mostlydiyrf/p3st/docs/P3ST_Partslist.xls

Sheet: P3ST_Parts
Mostly DIY RF / P3ST Transceiver Parts List
Ref | Qty | Value | Comment | Each | Ext |  | On Hand | Order
Motherboard
D1, D2, D3, D4, | 4 | 1N4148 DO-35 | DK 1N4148FS-ND | $0.020 | $0.08
J1, J5, | 22 | Female socket header 1x4 | DK S7002-ND | $0.232 | $5.10
K1, K2, K3, | 3 | DPDT | DK TX2-12V | $1.710 | $5.13
K4, | 1 | SPDT Relay | DK J102K1CS312VDC.20 | $0.935 | $0.94
Coax | 6ft | RG174 | Amazon / MOOKEERF | $0.260 | $1.66
Q1 | 1 | IRF9Z24NPBF P-Channel MOSFET | DK IRF9Z24NPBF-ND $0.75 | $0.750 | $0.75
Cable, 3-conductor | 2ft | Red, Green, White, 22AWG | Amazon / AOTOINK | $0.160 | $0.32
LCD Display | 1 | 16x2, 5V, I2C | Amazon / Teyleten | $2.780 | $2.78
Rotary Encoder module | 1 | KY-040 | Amazon / TAISS | $2.000 | $2.00
Potentiometer, 10K | 2 | 10K Audio Taper | Mouser 652-PDB181E420K103A2 | $0.970 | $1.94
PCB | 1 |  |  | $4.250 | $4.25
 |  |  | Module Total |  |  | $24.95
Audio Output Amp
Ref | Qty | Value |  |  |  |  | O.H | Order
C1, | 1 | 100μF electrolytic, radial, pins 0.1” | DK 732-8825-1-ND | $0.110 | $0.11
C2, | 1 | 10μF electrolytic, radial, pins 0.1” | DK 4191-EM1H100MP26307F2P9UCT-ND | $0.190 | $0.19
C3, | 1 | 470μF electrolytic, radial, pins 0.1” | DK 732-8708-1-ND | $0.130 | $0.13
C4, | 1 | 22μF electrolytic, radial, pins 0.1” | DK 732-8767-1-ND | $0.110 | $0.11
C5, C6, | 2 | 220μF electrolytic, radial, pins 0.1” | DK 732-8634-1-ND | $0.150 | $0.15
J1, J2, | 2 | Pin header, 1x4, right-angle | Amazon / Ruiwaer | $0.180 | $0.18
J5 | 1 | Pin Header, 1x3 | Amazon / | $0.050 | $0.05
Q1, | 1 | 2N2222A (TO-18) | EBay / LF Components | $0.800 | $0.80
R1, | 1 | 100K 1/4W carbon film | DK 13-CFR-25JT-52-100KCT-ND | $0.020 | $0.020
R2, | 1 | 47K 1/4W carbon film | DK 13-CFR-25JT-52-47KCT-ND | $0.020 | $0.020
R3, | 1 | 100 1/4W carbon film | DK 13-CFR-25JT-52-100RCT-ND | $0.020 | $0.020
R4, | 1 | 2.2K 1/4W carbon film | DK 13-CFR25SJT-52-2K2CT-ND | $0.020 | $0.020
R5, | 1 | 1K 1/4W carbon film | DK 13-CFR-25JT-52-100RCT-ND | $0.020 | $0.020
R6, | 1 | 2.2 1/4W carbon film | DK 2.2QBK-ND | $0.010 | $0.10
U1, | 1 | LM380N, 14-pin | DK 296-LM380N/NOPB-ND | $1.090 | $1.09
PCB | 1 |  |  | $0.500 | $0.50
 |  |  | Module Total |  |  | $3.01
BFO Mixer
Ref | Qty | Value
U1, | 1 | ADE-1 | DK 3157-ADE-1+CT-ND | $4.930 | $4.93
J1, J2, | 2 | Pin header, 1x4, right-angle |  | $0.090 | $0.18
PCB |  |  | JLC | $0.500 | $0.50
 |  |  | Module Total |  |  | $5.61
VFO Mixer
Ref | Qty | Value
U1, | 1 | ADE-1 | DK 3157-ADE-1+CT-ND | $4.930 | $4.93
J1, J2, | 2 | Pin header, 1x4, right-angle |  | $0.090 | $0.18
PCB |  |  | JLC | $0.500 | $0.50
 |  |  | Module Total |  |  | $5.61
Final Lowpass Filter
Ref | Qty | Value
C1, C4, | 2 | 220pF NP0/C0G ceramic | DK 399-13974-2-ND | $0.140 | $0.28
C2, C3, | 2 | 330pF NP0/C0G ceramic | DK 399-4231-ND | $0.140 | $0.28
C5, | 1 | 47pF NP0/C0G ceramic | DK 399-14095-1-ND | $0.210 | $0.21
L1, L2, L3, | 3 | T50-7 toroid core | Kits&Parts | $0.210 | $0.63
J1, J2, | 2 | Pin header, 1x4, right-angle | Amazon / | $0.090 | $0.18
Magnet Wire, 26AWG | 36” |  | Amazon / |  | $0.10
PCB |  |  | JLC | $0.500 | $0.50
 |  |  | Module Total |  |  | $2.18
Front-End Bandpass
Ref | Qty | Value
C1, C3, | 2 | 14.8pF trim capacitor | DK 2447-GKG30015-ND | $0.690 | $1.38
C2, | 1 | 1.5pF hand-made “gimmick” | Salvage | $0.000 | $0.00
C4, C5, | 2 | 39pF trim capacitor | DK 2447-GKG60015-ND | $0.690 | $1.38
J1, J2, | 2 | Pin header, 1x4, right-angle |  | $0.090 | $0.18
L1, L2, | 2 | T50-7 toroid | Kits&Parts | $0.210 | $0.42
Magnet Wire, 26AWG | 30” |  |  |  | $0.15
PCB |  |  |  | $0.500 | $0.50
 |  |  | Module Total |  |  | $4.01
IF Module
Ref | Qty | Value
C1 – C10 | 10 | 0.1μF ceramic X7R radial 0.10” | DK 399-C320C104K5R5TA7305CT-ND | $0.063 | $0.63
C11, C20 | 1 | 220pF 0.10” | DK 399-C315C221J1G5HA7303CT-ND | $0.160 | $0.32
C13 – C19 | 7 | 47pF NP0/C0G ceramic 0.10” | DK BC1009CT-ND | $0.060 | $0.42
J1 – J3 | 3 | Pin header, 1x4, right-angle | Amazon / | $0.090 | $0.18
L1, L4, | 2 | 22μH molded axial | DK 118-77F220K-TR-RCCT-ND | $0.170 | $0.34
L2, L3, | 2 | T50-7 toroid core | Kits&Parts | $0.210 | $0.42
Q1, Q2, | 2 | 2N2222A (TO-18) | EBay / LF Components | $0.800 | $1.60
R1, | 1 | 100 1/4W carbon film | DK 13-CFR-25JT-52-100RCT-ND | $0.020 | $0.02
R2, R8, | 2 | 680 1/4W carbon film | DK 13-CFR-25JT-52-680RCT-ND | $0.020 | $0.04
R3, R9, | 2 | 3K 1/4W carbon film | Mouser 603-CFR-25JB-52-3K | $0.010 | $0.02
R4, R7, | 2 | 1K 1/4W carbon film | DK 13-CFR-25JT-52-1KCT-ND | $0.020 | $0.04
R5, R11, | 2 | 10 1/4W carbon film | DK 13-CFR-25JR-52-10RCT-ND | $0.010 | $0.02
R12, | 1 | 51 1/4W carbon film | DK 13-CFR-25JR-52-51RCT-ND | $0.020 | $0.02
Y1 – Y10, | 10 | Crystal, HC49u, 4.915MHz | DK X1014-ND | $0.463 | $4.63
Magnet Wire, 26AWG | 36” |  | Amazon / |  | $0.20
PCB | 1 |  | JLC |  | $0.75
 |  |  | Module Total |  |  | $7.34
Microphone Amp
Ref | Qty | Value
C1, | 1 | 100μF electrolytic, radial, pins 0.1” | DK 732-8825-1-ND | $0.110 | $0.11
C2, | 1 | 470μF electrolytic, radial, pins 0.1” | DK 732-8708-1-ND | $0.130 | $0.13
C3, | 1 | 10μF electrolytic, radial, pins 0.1” | DK 4191-EM1H100MP26307F2P9UCT-ND | $0.190 | $0.19
C4, | 1 | 0.22μF, ceramic | DK 445-181223-ND | $0.180 | $0.18
C5, | 1 | 22μF electrolytic, radial, pins 0.1” | DK 732-8767-1-ND | $0.110 | $0.11
J1, J2, | 2 | Pin header, 1x4, right-angle | Amazon / | $0.090 | $0.18
J4 | 2 | Pin header, 1x3 | Amazon / | $0.050 | $0.05
JP | 1 | Jumper block, 2pin, 0.10” | Amazon / | $0.050 | $0.05
Q1, | 1 | 2N2222A (TO-18) | EBay / LF Components | $0.800 | $0.80
R1, | 1 | 47K 1/4W carbon film | DK 13-CFR-25JT-52-47KCT-ND | $0.020 | $0.02
R2, | 1 | 100K 1/4W carbon film | DK 13-CFR-25JT-52-100KCT-ND | $0.020 | $0.02
R3, | 1 | 100 1/4W carbon film | DK 13-CFR-25JT-52-100RCT-ND | $0.020 | $0.02
R4, | 1 | 1K 1/4W carbon film | DK 13-CFR-25JT-52-100RCT-ND | $0.020 | $0.02
R5, | 1 | 2.2K 1/4W carbon film | DK 13-CFR25SJT-52-2K2CT-ND | $0.020 | $0.02
R6, R7, | 2 | 4.7K 1/4W carbon film | DK 13-CFR-25JT-52-4K7CT-ND | $0.020 | $0.04
PCB | 1 |  | JLC | $0.500 | $0.50
 |  |  | Module Total |  |  | $2.44
RF Amp
Ref | Qty | Value
C1, | 1 | 0.01μF, ceramic 0.10” | DK 399-13905-1-ND | $0.140 | $0.14
C2, C4, C5, | 3 | 0.1μF, ceramic 0.10” | DK 399-C320C104K5R5TA7305CT-ND | $0.063 | $0.06
C3, | 1 | 0.047μF, ceramic 0.10” | DK BC1082CT-ND | $0.176 | $0.18
J1, J2, | 2 | Pin header, 1x4, right-angle | Amazon / | $0.090 | $0.18
L1, | 1 | 22μH, molded | DK 118-77F220K-TR-RCCT-ND | $0.170 | $0.17
Q1, | 1 | 2N2222A (TO-18) | EBay / LF Components | $0.800 | $0.80
R1, R3, | 2 | 3K 1/4W carbon film | Mouser 603-CFR-25JB-52-3K | $0.010 | $0.02
R2, | 1 | 680 1/4W carbon film | DK 13-CFR-25JT-52-680RCT-ND | $0.020 | $0.02
R4, | 1 | 10 1/4W carbon film | DK 13-CFR-25JR-52-10RCT-ND | $0.010 | $0.01
R7, | 1 | 330 1/4W carbon film | DK 13-CFR-25JT-52-330RCT-ND | $0.020 | $0.02
PCB | 1 |  | JLC | $0.500 | $0.50
 |  |  | Module Total |  |  | $2.10
Driver & Final Amp
Ref | Qty | Value
C1, | 1 | 0.01μF 0.2” | Mouser 80-C322C103K5R-TR | $0.150 | $0.15
C2, C4, C5, C6, C7, C8, C10, C11, C12, | 9 | 0.1μF 0.2” | Mouser 80-C318C104K5R5TATU | $0.154 | $1.39
C3, | 1 | 0.047μF 0.2” | DK BC1082CT-ND | $0.176 | $0.180
C9, | 1 | 220uF aluminum electrolytic | DK 732-8634-1-ND | $0.150 | $0.15
J1, J2, J3, | 3 | Pin header, 1x4, right-angle | Amazon / | $0.090 | $0.27
J | 2 | Pin header, 1x2, straight | Amazon / | $0.030 | $0.03
L1 | 2 | 22μH, molded, axial | DK 118-77F220K-TR-RCCT-ND | $0.170 | $0.17
L2, | 1 | 22μH, molded, radial | DK 495-6964-1-ND | $0.244 | $0.24
Q1, | 1 | 2N2219A | Jameco 38228 | $1.420 | $1.42
Q2, | 1 | IRF510 MOSFET TO-223 | DK IRF510PBF-ND | $0.780 | $0.78
Heat Sink | 1 | TO-220 Black / Wakefield-Vette | DK 345-1020-ND | $0.440 | $0.44
Heat Sink | 1 | TO-39 Black Crown / Boyd Laconia | DK 325705B00000G-ND | $2.060 | $2.06
R1, R3, | 2 | 2.7K 1/4W carbon film | DK 13-CFR-25JT-52-2K7CT-ND | $0.020 | $0.04
R2, | 1 | 680 1/4W carbon film | DK 13-CFR-25JT-52-680RCT-ND | $0.020 | $0.02
R4, R7, | 2 | 10 1/4W carbon film | DK 13-CFR-25JR-52-10RCT-ND | $0.010 | $0.02
R8, | 1 | 270 1/4W carbon film | DK 13-CFR-25JR-52-270RCT-ND | $0.020 | $0.02
R9, | 1 | 1K 1/4W carbon film | DK 13-CFR-25JT-52-100RCT-ND | $0.020 | $0.02
R10, | 1 | 51 1/4W carbon film | DK 13-CFR-25JR-52-51RCT-ND | $0.020 | $0.02
RV1, | 1 | 10K trim pot | DK 3362P-103LF-ND | $0.910 | $0.91
4-40 Screw/Nut | 1 |  |  | $0.050 | $0.05
T1, | 1 | FT50-43 Toroid Core | Kits&Parts | $0.400 | $0.40
U1, | 1 | LM317L, 3.3V regulator TO-92 | DK LM317LZRAGOSCT-ND | $0.490 | $0.49
Magnet Wire, 27AWG | 1 | Red, Green, twisted 8T/inch | Amazon / | $0.100 | $0.10
PCB | 1 |  | JLC | $0.750 | $0.75
 |  |  | Module Total |  |  | $10.12
Digital VFO/BFO
Ref | Qty | Value
C2, C4, | 2 | 220uF SMD | DK 399-6680-1-ND | $0.530 | $1.06
C11, C12, | 2 | 10μF SMD | DK 478-CM105X5R106K16ATCT-ND | $0.147 | $0.29
D1, | 1 | PMEG2010ER SMD | DK 1727-5192-1-ND | $0.183 | $0.18
J1, J2, | 1 | Pin header, 1x4, right-angle | Amazon / | $0.090 | $0.27
L1, | 1 | 680μH SMD | DK 445-180928-1-ND | $0.198 | $0.20
U1, | 1 | Si5351A, clone, | Amazon / Teyleten | $3.960 | $3.96
U2, | 1 | XIAO 2040 | Seeed (direct) | $3.500 | $3.50
U3, | 1 | TLV1117LV-3.3 Regulator, SMD | DK 296-21112-1-ND | $0.278 | $0.28
PCB | 1 |  | JLC | $0.500 | $0.50
 |  |  | Module Total |  |  | $10.24
 |  |  | Grand Total |  | $80.42

Sheet: Grouped
P3ST Transceiver Kit / Master Parts List 1.17.2025 |  | 1.16.25
Capacitors | Qty | Source & Part Number | Ea | Ext
0.01μF, ceramic, 0.20" LS | 1 | Mouser 80-C322C103K5R-TR | $0.150 | $0.15
0.01μF, ceramic, 0.10" LS | 1 | Digikey 399-13905-1-ND | $0.140 | $0.14
0.047μF, ceramic, 0.2” | 1 | Digikey 1C20X7R473K050B-ND | $0.176 | $0.18
0.047μF, ceramic 0.10" LS | 1 | Digikey BC1082CT-ND | $0.218 | $0.22
0.1μF, ceramic, 0.20" LS | 9 | Mouser 80-C318C104K5R5TATU | $0.154 | $1.39
0.1μF, ceramic 0.10" LS | 13 | Digikey 399-C320C104K5R5TA7305CT-ND | $0.063 | $0.82
0.22μF, ceramic, 0.10” LS | 1 | Digikey 445-181223-ND | $0.180 | $0.18
1.5pF, hand-made “gimmick” | 1 | (salvage 20-24AWG solid wire) | $0.000 | $0.00
100μF, electrolytic, radial, pins 0.1” | 2 | Digikey 732-8825-1-ND | $0.110 | $0.22
10μF, electrolytic, radial, pins 0.1” | 2 | Digikey 4191-EM1H100MP26307F2P9UCT-ND | $0.190 | $0.38
10μF, SMD | 2 | Digikey 478-CM105X5R106K16ATCT-ND | $0.147 | $0.29
14.8pF, trim capacitor | 2 | Digikey 2447-GKG30015-ND | $0.690 | $1.38
220pF, NP0/C0G ceramic 0.20" LS | 2 | Digikey 399-13974-2-ND | $0.140 | $0.28
220pF, NP0/C0G 0.10" LS | 1 | Digikey 399-C315C221J1G5HA7303CT-ND | $0.160 | $0.16
220uF, SMD | 2 | Digikey 399-6680-1-ND | $0.530 | $1.06
220μF, electrolytic, radial, pins 0.1” | 3 | Digikey 732-8634-1-ND | $0.150 | $0.45
22μF, electrolytic, radial, pins 0.1” | 2 | Digikey 732-8767-1-ND | $0.110 | $0.22
330pF, NP0/C0G ceramic 0.20" LS | 2 | Digikey 399-4231-ND | $0.140 | $0.28
39pF, trim capacitor | 2 | Digikey 2447-GKG60015-ND | $0.690 | $1.38
470μF, electrolytic, radial, pins 0.1” | 2 | Digikey 732-8708-1-ND | $0.130 | $0.26
47pF, NP0/C0G ceramic 0.20" LS | 1 | Digikey 399-14095-1-ND | $0.210 | $0.21
47pF, NP0/C0G ceramic 0.10" LS | 7 | Digikey BC1009CT-ND | $0.060 | $0.42
Crystals | Qty | Source & Part Number | Ea | Ext
Crystal, HC49u, 4.915MHz | 10 | Digikey X1014-ND | $0.463 | $4.63
Diodes | Qty | Source & Part Number | Ea | Ext
PMEG2010ER SMD | 1 | Digikey 1727-5192-1-ND | $0.183 | $0.18
1N4148 DO-35 | 4 | Digikey 1N4148FS-ND | $0.020 | $0.08
Hardware | Qty | Source & Part Number | Ea | Ext
Screw/Nut, 4-40 | 1 | Ace Hardware | $0.050 | $0.05
TO-220 Black / Wakefield-Vette | 1 | Digikey 345-1020-ND | $0.440 | $0.44
TO-39 Black Crown / Boyd Laconia | 1 | Digikey 325705B00000G-ND | $2.060 | $2.06
Headers | Qty | Source & Part Number | Ea | Ext
Pin header, 1x2, straight | 2 | Amazon / HiLetgo (from 40-pin, 0.10”) | $0.030 | $0.06
Pin header, 1x3 | 3 | Amazon / HiLetgo (from 40-pin, 0.10”) | $0.050 | $0.15
Pin header, 1x4, right-angle | 22 | Amazon / Ruiwaer (from 40-pin, 0.10”) | $0.090 | $1.98
Female socket header 1x4 | 22 | Digikey S7002-ND | $0.232 | $5.10
Jumper block, 2pin, 0.10" LS | 3 | Amazon / California JOS | $0.050 | $0.15
Inductors | Qty | Source & Part Number | Ea | Ext
22μH, molded, axial | 5 | Digikey 118-77F220K-TR-RCCT-ND | $0.170 | $0.85
22μH, molded, radial | 1 | Digikey 495-6964-1-ND | $0.244 | $0.24
680μH SMD | 1 | Digikey 445-180928-1-ND | $0.198 | $0.20
Integrated | Qty | Source & Part Number | Ea | Ext
LM380N, 14-pin | 1 | Digikey 296-LM380N/NOPB-ND | $1.090 | $1.09
ADE-1 | 2 | Digikey 3157-ADE-1+CT-ND | $4.930 | $9.86
LM317L, 3.3V regulator TO-92 | 1 | Digikey LM317LZRAGOSCT-ND | $0.490 | $0.49
TLV1117LV-3.3 Regulator, SMD | 1 | Digikey 296-21112-1-ND | $0.278 | $0.28
Modules | Qty | Source & Part Number | Ea | Ext
LCD Display, 16x2, 5V, I2C | 1 | Amazon / Teyleten | $2.780 | $2.78
Rotary Encoder Module, KY-040 | 1 | Amazon / TAISS | $2.000 | $2.00
XIAO 2040 | 1 | Seeed Studios (direct) | $3.500 | $3.50
Si5351A, clone, | 1 | Amazon / Teyleten | $3.960 | $3.96
Potentiometers | Qty | Source & Part Number | Ea | Ext
10K trim pot | 1 | Digikey 3362P-103LF-ND | $0.910 | $0.91
10K Audio Taper | 2 | Mouser 652-PDB181E420K103A2 | $0.970 | $1.94
Relays | Qty | Source & Part Number | Ea | Ext
DPDT, 12V | 3 | Digikey TX2-12V | $1.710 | $5.13
SPDT, 12V | 1 | Digikey J102K1CS312VDC.20 | $0.935 | $0.94
Resistors | Qty | Source & Part Number | Ea | Ext
10 1/4W carbon film | 5 | Digikey 13-CFR-25JR-52-10RCT-ND | $0.010 | $0.05
100 1/4W carbon film | 3 | Digikey 13-CFR-25JT-52-100RCT-ND | $0.020 | $0.06
100K 1/4W carbon film | 2 | Digikey 13-CFR-25JT-52-100KCT-ND | $0.020 | $0.04
1K 1/4W carbon film | 5 | Digikey 13-CFR-25JT-52-100RCT-ND | $0.020 | $0.10
2.2 1/4W carbon film | 1 | Digikey 2.2QBK-ND | $0.010 | $0.01
2.2K 1/4W carbon film | 2 | Digikey 13-CFR25SJT-52-2K2CT-ND | $0.020 | $0.04
2.7K 1/4W carbon film | 2 | Digikey 13-CFR-25JT-52-2K7CT-ND | $0.020 | $0.04
270 1/4W carbon film | 1 | Digikey 13-CFR-25JR-52-270RCT-ND | $0.020 | $0.02
330 1/4W carbon film | 1 | Digikey 13-CFR-25JT-52-330RCT-ND | $0.020 | $0.02
3K 1/4W carbon film | 4 | Mouser 603-CFR-25JB-52-3K | $0.010 | $0.04
4.7K 1/4W carbon film | 2 | Digikey 13-CFR-25JT-52-4K7CT-ND | $0.020 | $0.04
47K 1/4W carbon film | 2 | Digikey 13-CFR-25JT-52-47KCT-ND | $0.020 | $0.04
51 1/4W carbon film | 2 | Digikey 13-CFR-25JR-52-51RCT-ND | $0.020 | $0.04
680 1/4W carbon film | 4 | Digikey 13-CFR-25JT-52-680RCT-ND | $0.020 | $0.08
Toroids | Qty | Source & Part Number | Ea | Ext
T50-7 toroid core | 7 | kitsandparts.com | $0.210 | $1.47
FT50-43 Toroid Core | 1 | kitsandparts.com | $0.400 | $0.40
Transistors | Qty | Source & Part Number | Ea | Ext
2N2222A (TO-18) | 5 | EBay / LF Components | $0.800 | $4.00
2N2219A (TO-39/TO-5) | 1 | Jameco 38228 | $1.420 | $1.42
IRF510 MOSFET TO-223 | 1 | Digikey IRF510PBF-ND | $0.780 | $0.78
IRF9Z24NPBF P-Channel MOSFET | 1 | Digikey IRF9Z24NPBF-ND $0.75 | $0.750 | $0.75
Wire & Cable | Qty | Source & Part Number | Ea | Ext
3-Conductor Cable, R-G-W, 22AWG | 2ft | Amazon / AOTOINK | $0.160 | $0.32
Coax, RG174 | 6ft | Amazon / MOOKEERF | $0.260 | $1.66
Magnet Wire, 26AWG | 102” | Amazon / BINNEKER |  | $0.10
Magnet Wire, 27AWG, Red, Green | 1 | Amazon / | $0.100 | $0.10

Sheet: Counts
P3ST Master Parts List |  | 1.16.25
Capacitors |  |  | Each | Ext | On Hand
0.01μF, ceramic, 0.20" LS | 1 | Mouser 80-C322C103K5R-TR | $0.150 | $0.15
0.01μF, ceramic, 0.10" LS | 1 | DK 399-13905-1-ND | $0.140 | $0.14
0.047μF, ceramic, 0.2” | 1 | DK BC1082CT-ND | $0.176 | $0.180
0.047μF, ceramic 0.10" LS | 1 | DK BC1082CT-ND | $0.176 | $0.18
0.1μF, ceramic, 0.20" LS | 9 | Mouser 80-C318C104K5R5TATU | $0.154 | $1.39
0.1μF, ceramic 0.10" LS | 13 | DK 399-C320C104K5R5TA7305CT-ND | $0.063 | $0.06
0.22μF, ceramic | 1 | DK 445-181223-ND | $0.180 | $0.18
1.5pF, hand-made “gimmick” | 1 | Salvage (20-24AWG solid wire) | $0.000 | $0.00
100μF, electrolytic, radial, pins 0.1” | 2 | DK 732-8825-1-ND | $0.110 | $0.11
10μF, electrolytic, radial, pins 0.1” | 2 | DK 4191-EM1H100MP26307F2P9UCT-ND | $0.190 | $0.19
10μF, SMD | 2 | DK 478-CM105X5R106K16ATCT-ND | $0.147 | $0.29
14.8pF, trim capacitor | 2 | DK 2447-GKG30015-ND | $0.690 | $1.38
220pF, NP0/C0G ceramic 0.20" LS | 2 | DK 399-13974-2-ND | $0.140 | $0.28
220pF, NP0/C0G 0.10" LS | 1 | DK 399-C315C221J1G5HA7303CT-ND | $0.160 | $0.32
220uF, SMD | 2 | DK 399-6680-1-ND | $0.530 | $1.06
220μF, electrolytic, radial, pins 0.1” | 3 | DK 732-8634-1-ND | $0.150 | $0.15
22μF, electrolytic, radial, pins 0.1” | 2 | DK 732-8767-1-ND | $0.110 | $0.11
330pF, NP0/C0G ceramic 0.20" LS | 2 | DK 399-4231-ND | $0.140 | $0.28
39pF, trim capacitor | 2 | DK 2447-GKG60015-ND | $0.690 | $1.38
470μF, electrolytic, radial, pins 0.1” | 2 | DK 732-8708-1-ND | $0.130 | $0.13
47pF, NP0/C0G ceramic 0.20" LS | 1 | DK 399-14095-1-ND | $0.210 | $0.21
47pF, NP0/C0G ceramic 0.10" LS | 7 | DK BC1009CT-ND | $0.060 | $0.42
Crystals |  |  | Each | Ext | On Hand
Crystal, HC49u, 4.915MHz | 10 | DK X1014-ND | $0.463 | $4.63
Diodes |  |  | Each | Ext | On Hand
PMEG2010ER SMD | 1 | DK 1727-5192-1-ND | $0.183 | $0.18
1N4148 DO-35 | 4 | DK 1N4148FS-ND | $0.020 | $0.08
Hardware |  |  | Each | Ext | On Hand
Screw/Nut, 4-40 | 1 | Ace Hardware | $0.050 | $0.05
TO-220 Black / Wakefield-Vette | 1 | DK 345-1020-ND | $0.440 | $0.44
TO-39 Black Crown / Boyd Laconia | 1 | DK 325705B00000G-ND | $2.060 | $2.06
Headers |  |  | Each | Ext | On Hand
Pin header, 1x2, straight | 2 | Amazon / HiLetgo (from 40-pin, 0.10”) | $0.030 | $0.03
Pin header, 1x3 | 3 | Amazon / HiLetgo (from 40-pin, 0.10”) | $0.050 | $0.05
Pin header, 1x4, right-angle | 22 | Amazon / Ruiwaer (from 40-pin, 0.10”) | $0.090 | $0.18
Female socket header 1x4 | 22 | DK S7002-ND | $0.232 | $5.10
Jumper block, 2pin, 0.10" LS | 3 | Amazon / California JOS | $0.050 | $0.05
Inductors |  |  | Each | Ext | On Hand
22μH, molded, axial | 5 | DK 118-77F220K-TR-RCCT-ND | $0.170 | $0.17
22μH, molded, radial | 1 | DK 495-6964-1-ND | $0.244 | $0.24
680μH SMD | 1 | DK 445-180928-1-ND | $0.198 | $0.20
Integrated |  |  | Each | Ext | On Hand
LM380N, 14-pin | 1 | DK 296-LM380N/NOPB-ND | $1.090 | $1.09
ADE-1 | 2 | DK 3157-ADE-1+CT-ND | $4.930 | $4.93
LM317L, 3.3V regulator TO-92 | 1 | DK LM317LZRAGOSCT-ND | $0.490 | $0.49
TLV1117LV-3.3 Regulator, SMD | 1 | DK 296-21112-1-ND | $0.278 | $0.28
Modules |  |  | Each | Ext | On Hand
LCD Display, 16x2, 5V, I2C | 1 | Amazon / Teyleten | $2.780 | $2.78
Rotary Encoder Module, KY-040 | 1 | Amazon / TAISS | $2.000 | $2.00
XIAO 2040 | 1 | Seeed Studios (direct) | $3.500 | $3.50
Si5351A, clone, | 1 | Amazon / Teyleten | $3.960 | $3.96
Potentiometers |  |  | Each | Ext | On Hand
10K trim pot | 1 | DK 3362P-103LF-ND | $0.910 | $0.91
10K Audio Taper | 2 | Mouser 652-PDB181E420K103A2 | $0.970 | $1.94
Relays |  |  | Each | Ext | On Hand
DPDT, 12V | 3 | DK TX2-12V | $1.710 | $5.13
SPDT, 12V | 1 | DK J102K1CS312VDC.20 | $0.935 | $0.94
Resistors |  |  | Each | Ext | On Hand
100K 1/4W carbon film | 1 | DK 13-CFR-25JT-52-100KCT-ND | $0.020 | $0.020
100 1/4W carbon film | 1 | DK 13-CFR-25JT-52-100RCT-ND | $0.020 | $0.02
47K 1/4W carbon film | 1 | DK 13-CFR-25JT-52-47KCT-ND | $0.020 | $0.02
3K 1/4W carbon film | 2 | Mouser 603-CFR-25JB-52-3K | $0.010 | $0.02
2.7K 1/4W carbon film | 2 | DK 13-CFR-25JT-52-2K7CT-ND | $0.020 | $0.04
51 1/4W carbon film | 1 | DK 13-CFR-25JR-52-51RCT-ND | $0.020 | $0.02
51 1/4W carbon film | 1 | DK 13-CFR-25JR-52-51RCT-ND | $0.020 | $0.02
47K 1/4W carbon film | 1 | DK 13-CFR-25JT-52-47KCT-ND | $0.020 | $0.020
100K 1/4W carbon film | 1 | DK 13-CFR-25JT-52-100KCT-ND | $0.020 | $0.02
680 1/4W carbon film | 1 | DK 13-CFR-25JT-52-680RCT-ND | $0.020 | $0.02
680 1/4W carbon film | 1 | DK 13-CFR-25JT-52-680RCT-ND | $0.020 | $0.02
680 1/4W carbon film | 2 | DK 13-CFR-25JT-52-680RCT-ND | $0.020 | $0.04
100 1/4W carbon film | 1 | DK 13-CFR-25JT-52-100RCT-ND | $0.020 | $0.020
100 1/4W carbon film | 1 | DK 13-CFR-25JT-52-100RCT-ND | $0.020 | $0.02
3K 1/4W carbon film | 2 | Mouser 603-CFR-25JB-52-3K | $0.010 | $0.02
2.2K 1/4W carbon film | 1 | DK 13-CFR25SJT-52-2K2CT-ND | $0.020 | $0.020
1K 1/4W carbon film | 1 | DK 13-CFR-25JT-52-100RCT-ND | $0.020 | $0.02
10 1/4W carbon film | 1 | DK 13-CFR-25JR-52-10RCT-ND | $0.010 | $0.01
1K 1/4W carbon film | 2 | DK 13-CFR-25JT-52-1KCT-ND | $0.020 | $0.04
10 1/4W carbon film | 2 | DK 13-CFR-25JR-52-10RCT-ND | $0.010 | $0.02
1K 1/4W carbon film | 1 | DK 13-CFR-25JT-52-100RCT-ND | $0.020 | $0.020
2.2K 1/4W carbon film | 1 | DK 13-CFR25SJT-52-2K2CT-ND | $0.020 | $0.02
10 1/4W carbon film | 2 | DK 13-CFR-25JR-52-10RCT-ND | $0.010 | $0.02
2.2 1/4W carbon film | 1 | DK 2.2QBK-ND | $0.010 | $0.10
4.7K 1/4W carbon film | 2 | DK 13-CFR-25JT-52-4K7CT-ND | $0.020 | $0.04
330 1/4W carbon film | 1 | DK 13-CFR-25JT-52-330RCT-ND | $0.020 | $0.02
270 1/4W carbon film | 1 | DK 13-CFR-25JR-52-270RCT-ND | $0.020 | $0.02
1K 1/4W carbon film | 1 | DK 13-CFR-25JT-52-100RCT-ND | $0.020 | $0.02
Toroids |  |  | Each | Ext | On Hand
T50-7 toroid core | 7 | Kits&Parts | $0.210 | $0.42
FT50-43 Toroid Core | 1 | Kits&Parts | $0.400 | $0.40
Transistors |  |  | Each | Ext | On Hand
2N2222A (TO-18) | 5 | EBay / LF Components | $0.800 | $0.80
2N2219A (TO-39/TO-5) | 1 | Jameco 38228 | $1.420 | $1.42
IRF510 MOSFET TO-223 | 1 | DK IRF510PBF-ND | $0.780 | $0.78
IRF9Z24NPBF P-Channel MOSFET | 1 | DK IRF9Z24NPBF-ND $0.75 | $0.750 | $0.75
Wire & Cable |  |  | Each | Ext | On Hand
3-Conductor Cable, R-G-W, 22AWG | 2ft | Amazon / AOTOINK | $0.160 | $0.32
Coax, RG174 | 6ft | Amazon / MOOKEERF | $0.260 | $1.66
Magnet Wire, 26AWG | 102” | Amazon / BINNEKER |  | $0.10
Magnet Wire, 27AWG, Red, Green, twisted 8T/inch | 1 | Amazon / | $0.100 | $0.10
