mostlydiyrf/p3st/docs/P3ST_bfo_mixer_Assembly_and_Test.pdf

## Mostly DIY RF / P3ST Transceiver Kit

# BFO Mixer Module

## Assembly and Test Instructions

In keeping with the minimal design philosophy employed in the P3ST, the BFO mixer is an ADE-1+, a commercially-available unit from Mini Circuits. It is a double-balanced diode-ring design requiring an LO drive level of +7dBm. Though it is technically a surface-mount part, it is large enough to handle and solder with no difficulty. Here's its internal circuit:

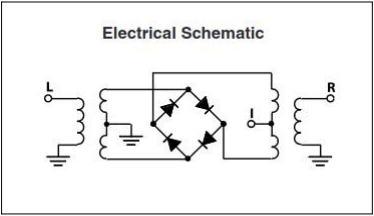
[picture p41: figure]

See attached datasheet for more information.

## Assembly

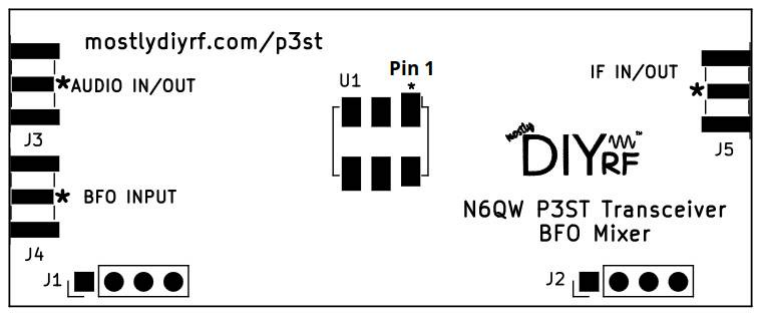
[picture p42: figure]

Assembly could hardly be easier. There are only three components to solder to the module board: two right-angle 4-pin headers and the single ADE-1+. Observe Pin 1 orientation as shown above. Though it's a surface-mount part, it is large enough to handle and solder easily. See the video at https://bit.ly/surface-mount-tips on SMD soldering. The large "D-PAK" component shown is most similar to the ADE-1+ in size. Easy-peasy.

As with the 4-pin headers on all the modules, install them with the right-angle pins extending out the back side of the PCB. Also as with all the modules, the input and output pads may be used either to attach board-edge-style SMA connectors or, with the help of the thru-holes in the middle of the pads, directly-soldered connections may be made.

Mostly DIY RF / P3ST Transceiver Kit / BFO Mixer Module / 2

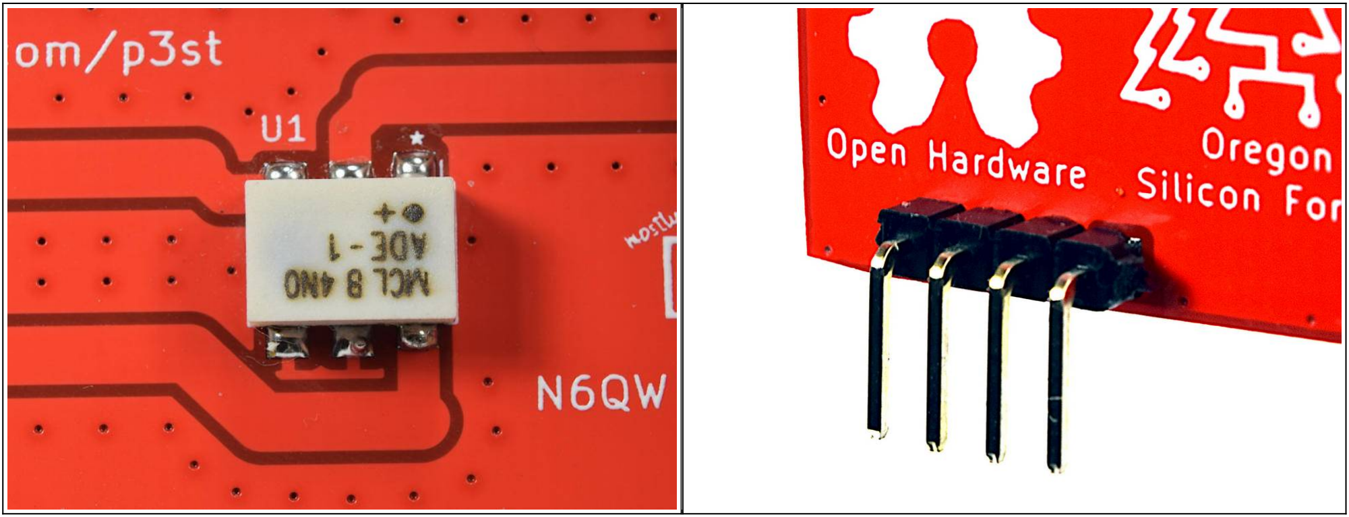
[picture p43: figure]

ADE-1+ orientation. Yes, it mounts upside-down. | Four-pin right-angle head orientation

## Test Procedure

1. Using magnification, visually inspect both sides of the PCB to look for solder bridging or other conductive debris. It's usually best to clean off flux residue first.
2. If you have them, you can test the full operation of the ADE-1+ mixer with a signal generator and spectrum analyzer. For more on doing so, see the video at https://bit.ly/diode-ringmixer and https://bit.ly/testing_dbms. In the alternative (or in addition), you can test for "static" (DC) characteristics by ensuring that:
a) there is continuity (a small resistance of approximately 100mΩ) between Audio IN/OUT

and GND, and between BFO INPUT and GND.

b) there is an apparent resistance (the result of two diode voltage drops) of approximately 8.9KΩ between the IF IN/OUT and GND.
c) there is full continuity between J1 Pin 4 and GND, and between J2 Pins 3 & 4 and

GND.

d) there is no continuity between J1 Pins 1, 2, & 3 and GND, or between J2 Pins 1 & 2

and GND. The ADE-1+ does not need power from the motherboard.


## General Tips and Tricks

■ Save yourself some troubleshooting grief later on: test every part before you install it. Though MDRF uses components only from reputable sources, even those have finite failure rates. Testing is easier than it sounds, and it's quick since you only need to test for part failure.

■ Test resistors for continuity and approximate value (±5%)
■ Test capacitors for no continuity. DC resistance should be infinite or ultra high

after they charge up during testing. Note: this may take several seconds since the current an ohmmeter injects is very low.
■ Test diodes to ensure no reverse continuity and a forward voltage drop of approximately 0.65V.
■ Test transistors for high or infinite collector/drain and emitter/source DC resistance. Use diode test function to test base-emitter junction (base as anode). If you have a dedicated transistor testor, use that.

■ Double-check component markings and color codes. Pin up a reminder chart nearby. Whether you need it or not, look it over before an assembly session.

■ It's usually easiest to begin stuffing parts in the center of a PCB and work your way out.

■ Insert component leads and bend them about 45 degrees to keep the parts from falling out when you flip the board over to solder on the backside.

■ The PCB holes are "through-plated" (copper plated and solder coated on the insides of the holes) for maximum connectivity and mechanical strength, but this makes rework (removing a part and installing a new one) a little more difficult than with other circuit-board methods. So before soldering, double check the component value and orientation.

■ A good habit is to install components such that they are "right-reading" relative to circuit-board nomenclature. For a resistor, this would mean the color code would read from left to right when the silk-screened legend does. For parts oriented vertically, they should read from top to bottom. For other non-polarized parts (such as ceramic capacitors) it's useful to install so their values can be read at a later time (and not, for instance, obscured by another part).

■ Because the power, input, and output pins are closely-spaced, do not use alligator (a.k.a. crocodile) clips for temporary connections. Dupont-style male jumper leads, however, are very convenient for this purpose.

■ Using magnification, visually inspect both sides of the PCB to look for solder bridging or other conductive debris. It's usually best to clean off flux residue first. Isopropyl alcohol (>90%) is excellent for this purpose as it's cheap and dries quickly.
