mostlydiyrf/p3st/errata/M3FOR_cabling_corrections.pdf

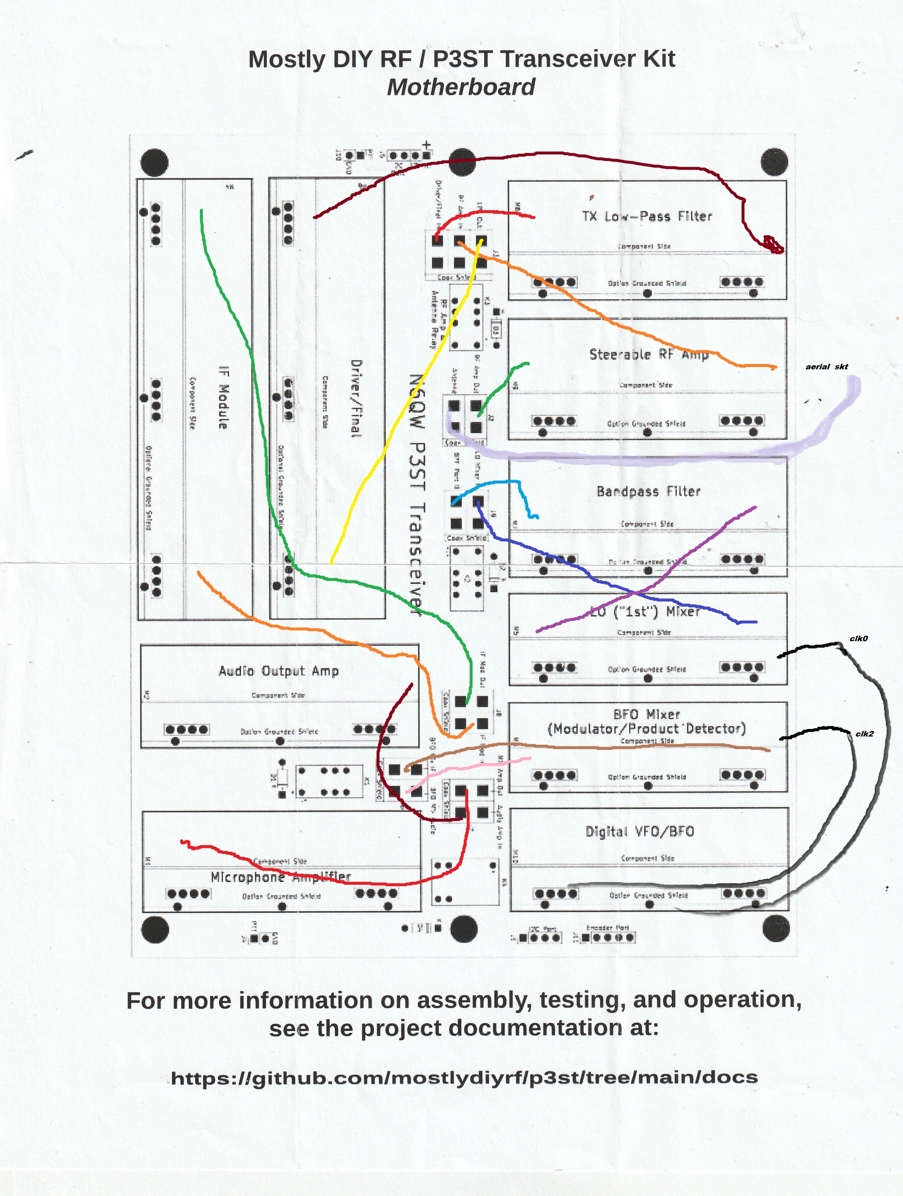
[picture p44: page 1]
