mostlydiyrf/p3st/docs/P3ST_Schematics.pdf

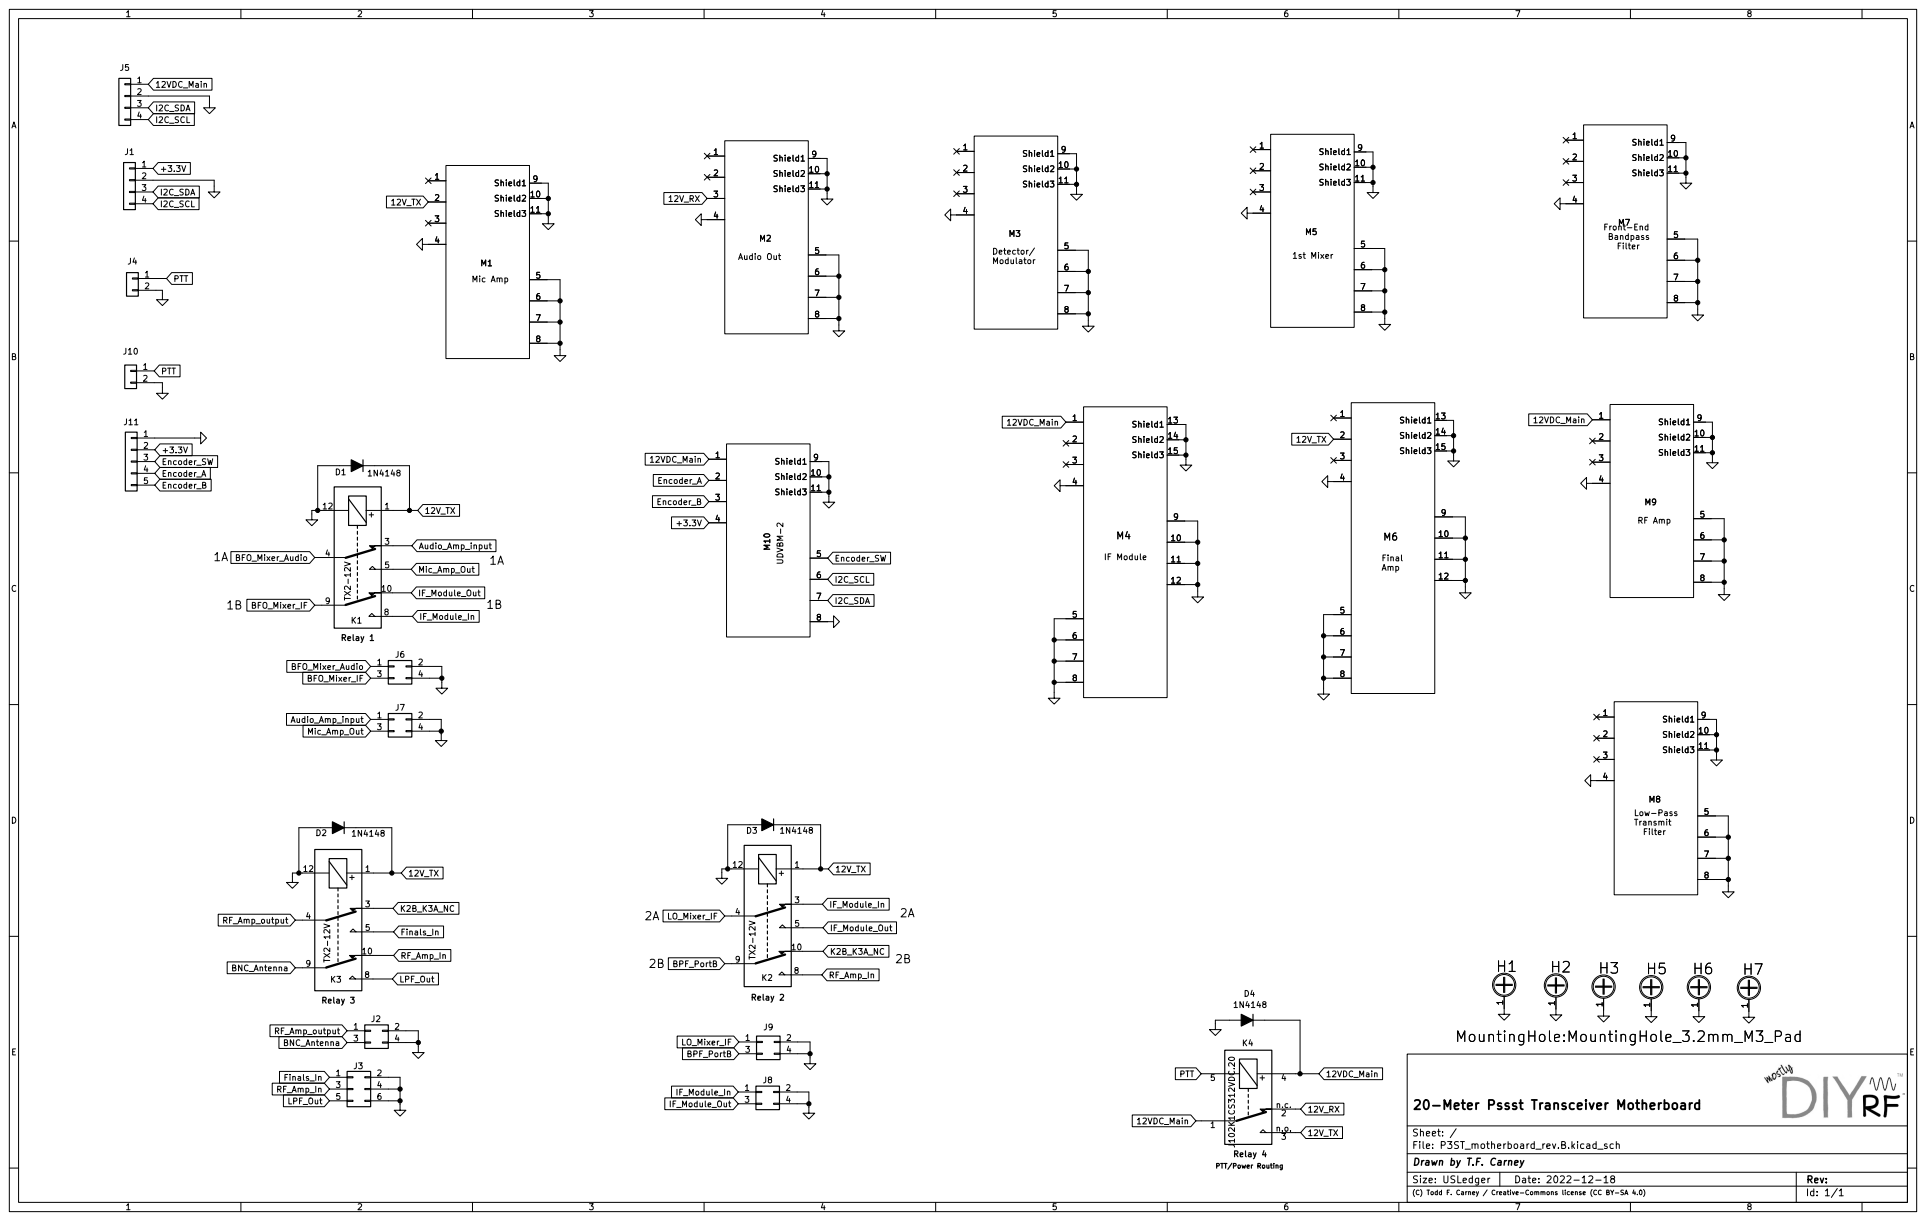
[picture p45: page 1]

Low-Pass Transmit Filter 1A
BFO_Mixer_Audio BFO_Mixer_IF BFO_Mixer_IF BFO_Mixer_Audio Mic_Amp_Out

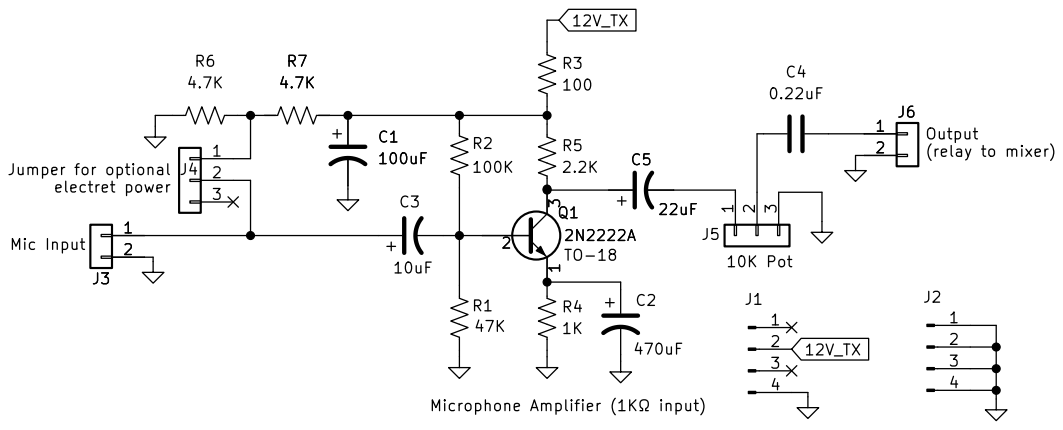
[picture p46: page 2]

Id: 1/1 Drawn by T.F. Carney File: Pssst_microphone_amp.kicad_sch Sheet: / Pssst Microphone Amplifier

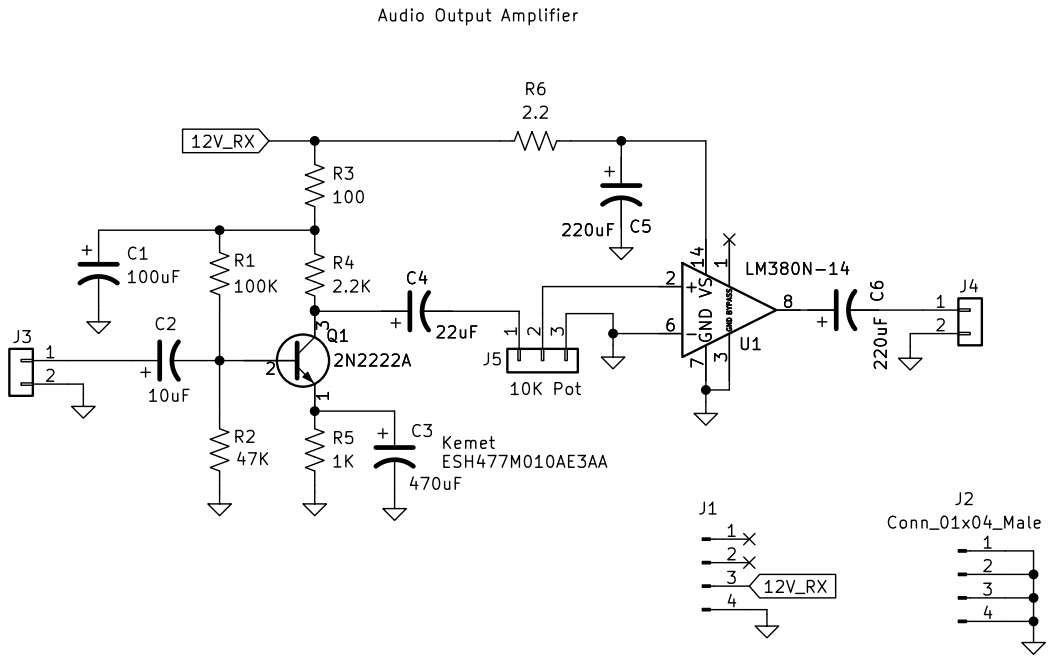
[picture p47: page 3]

Id: 1/1 Drawn by T.F. Carney File: Pssst_audio_out.kicad_sch Sheet: / Pssst Audio Output Amplifier

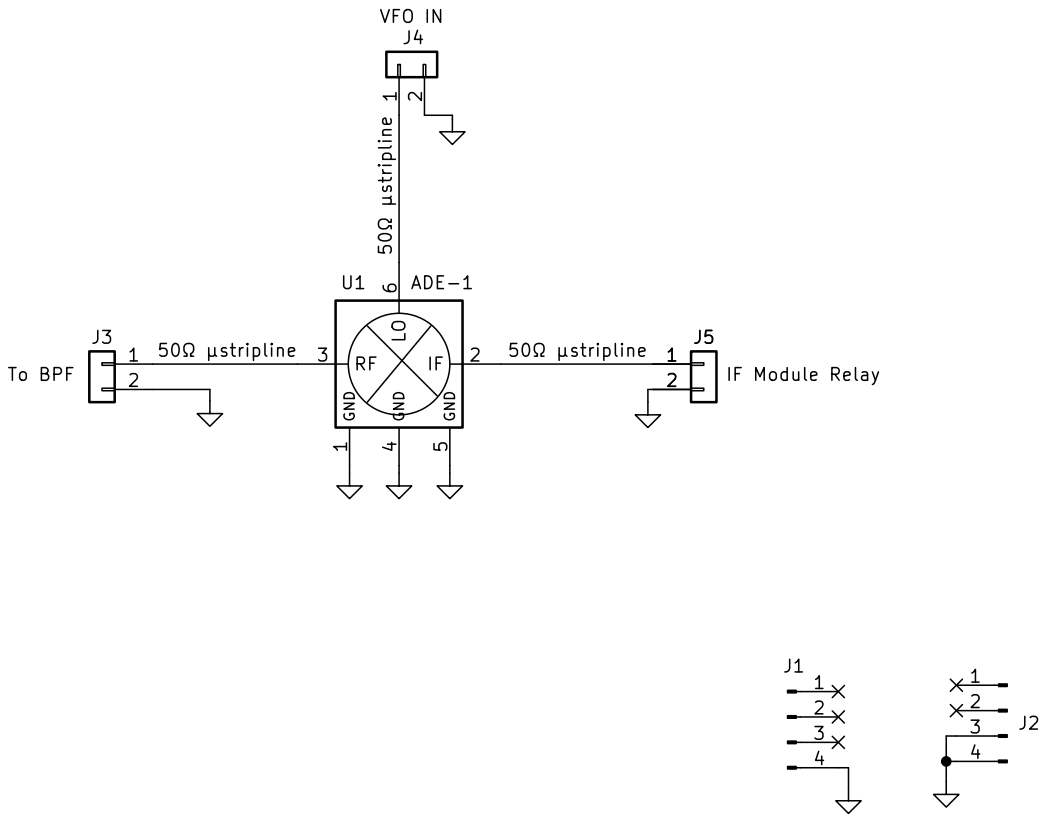
[picture p48: page 4]

Id: 1/1 Drawn by T.F. Carney File: Pssst_VFO_Mixer.kicad_sch Sheet: / Pssst VFO Mixer

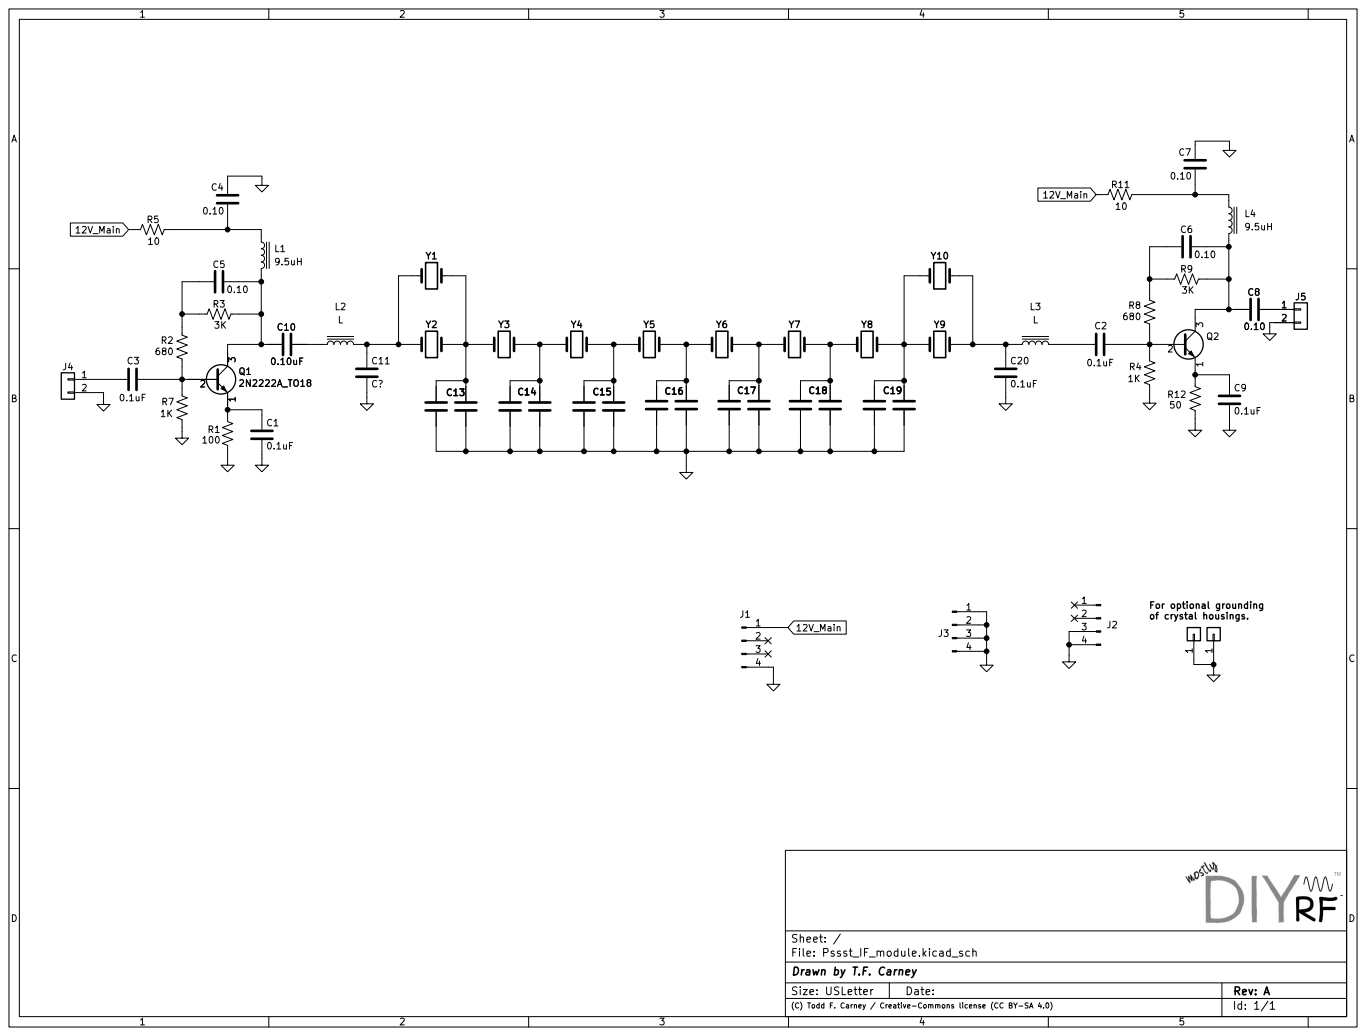
[picture p49: page 5]

Id: 1/1 Drawn by T.F. Carney File: Pssst_IF_module.kicad_sch Sheet: /

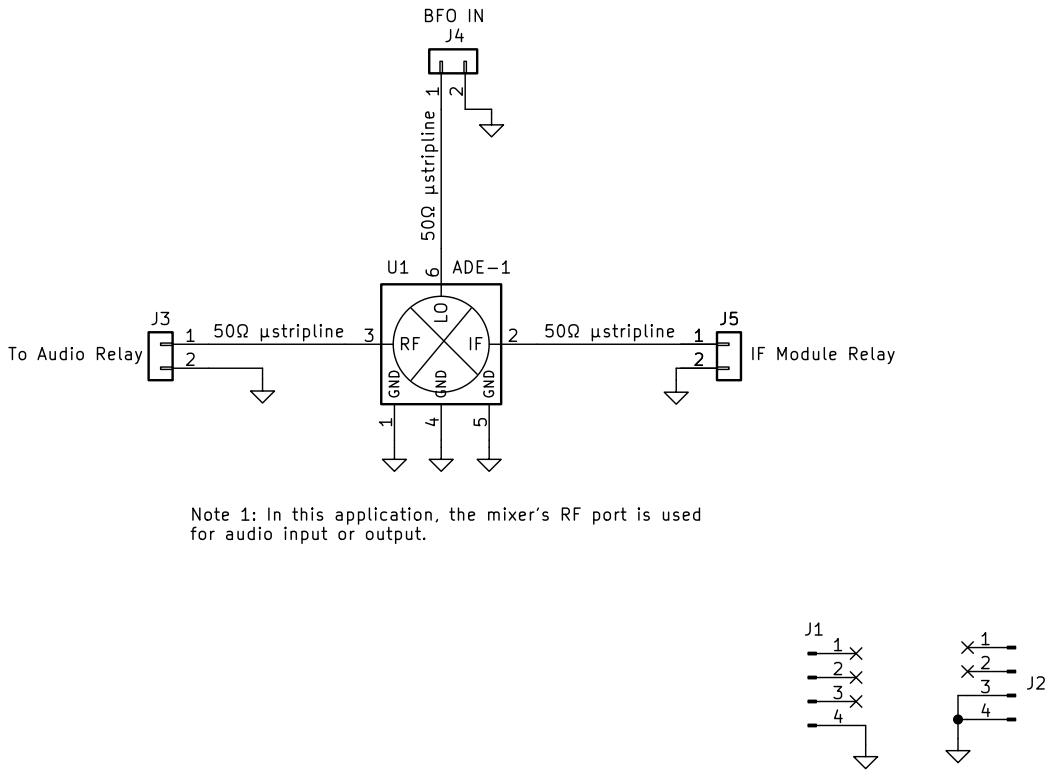
[picture p50: page 6]

Id: 1/1 Drawn by T.F. Carney File: Pssst_BFO_mixer.kicad_sch Sheet: / Pssst BFO Mixer GND

for audio input or output.

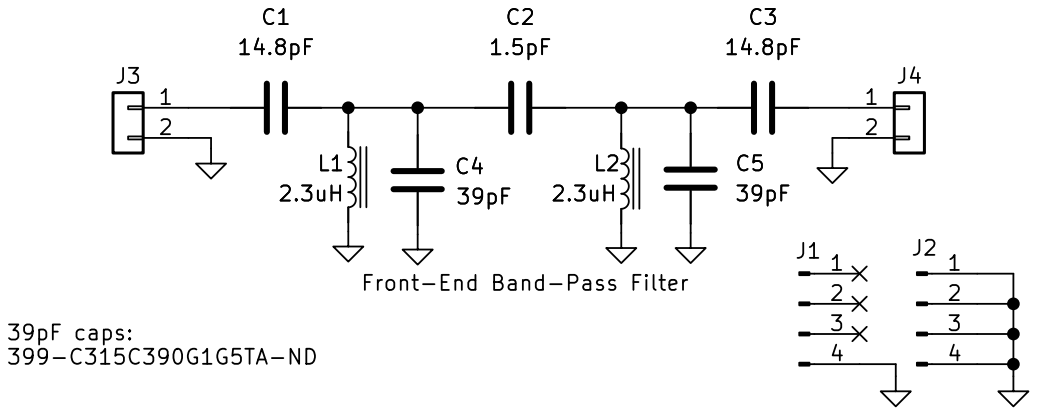
[picture p51: page 7]

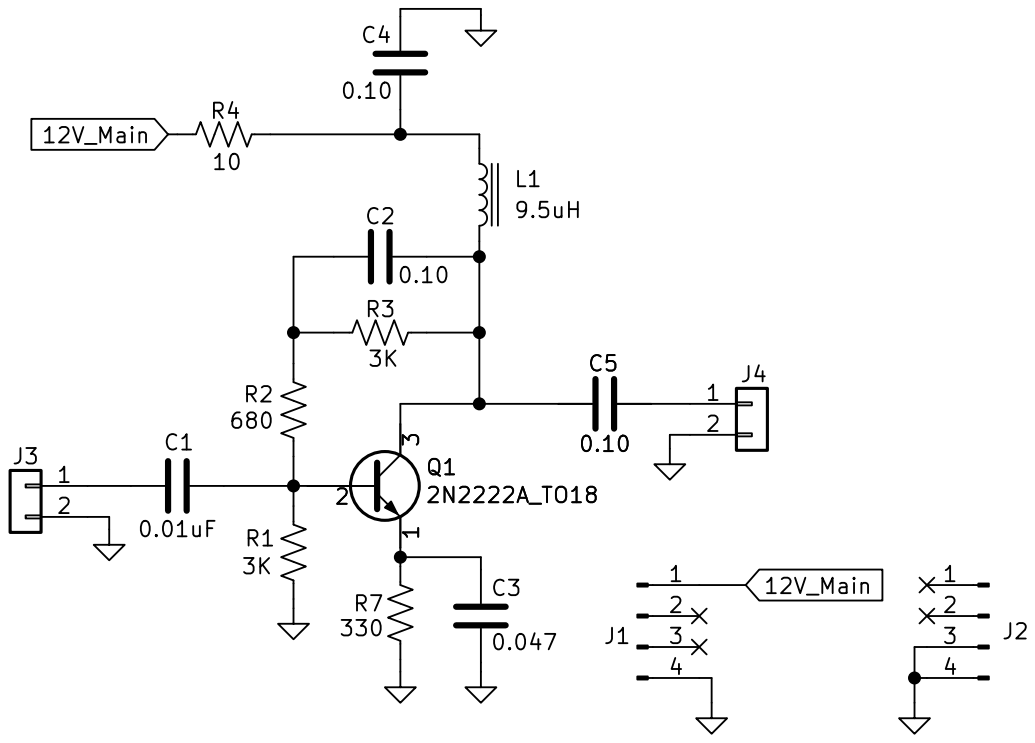
[picture p52: page 8]

Id: 1/1 Drawn by T.F. Carney File: Pssst_RF_amp.kicad_sch Sheet: /

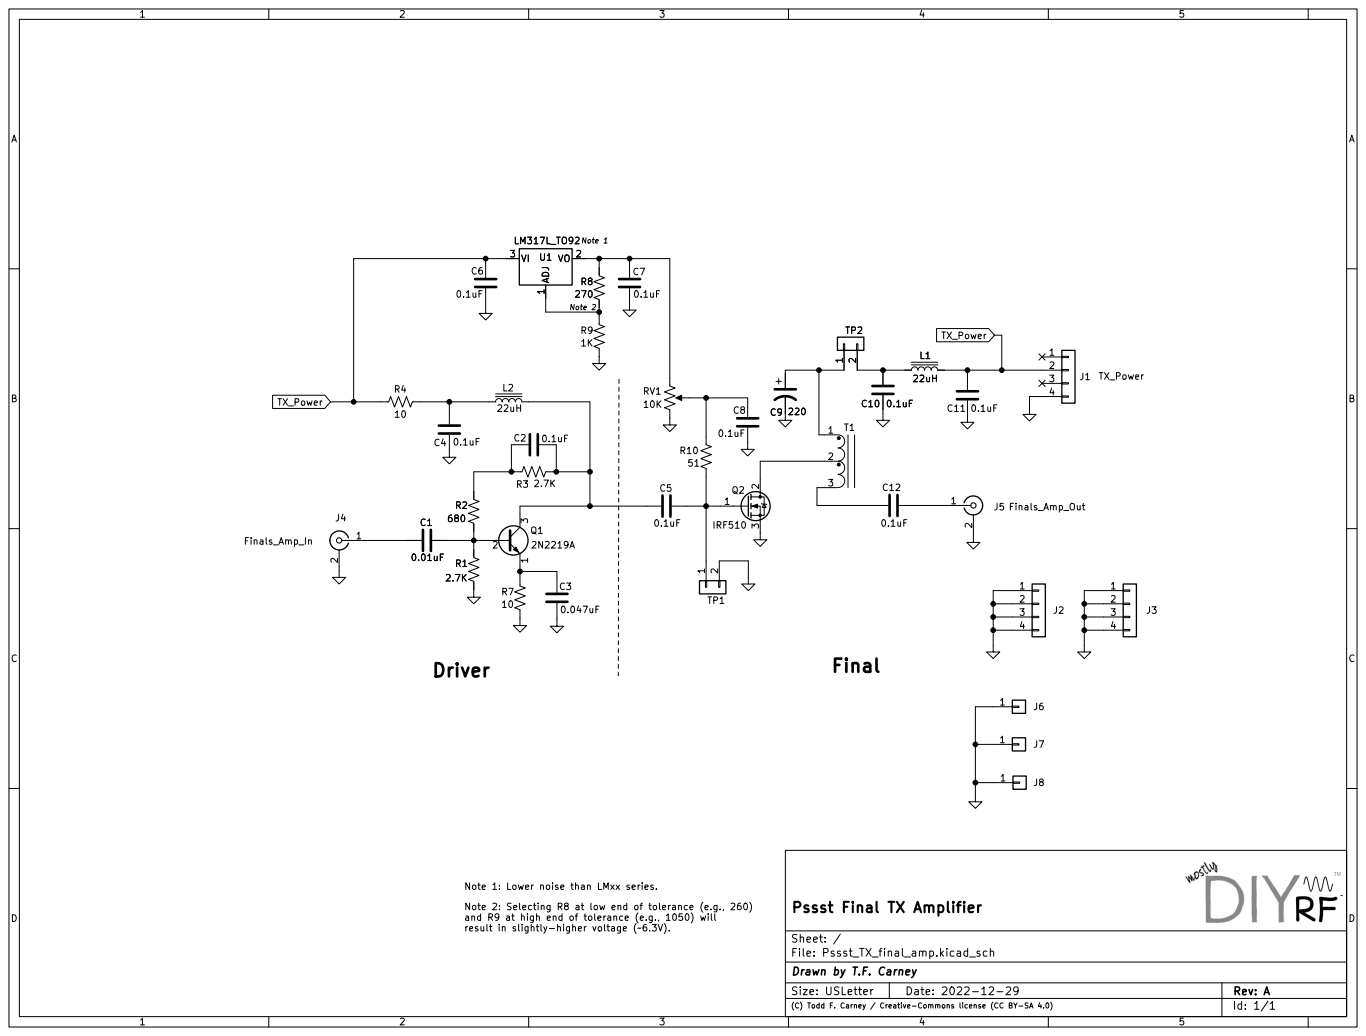
[picture p53: page 9]

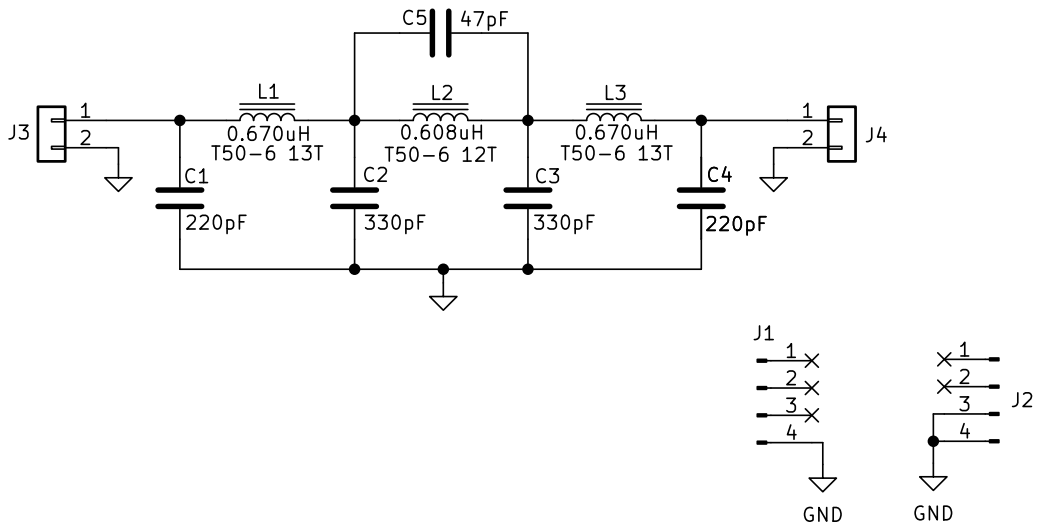
[picture p54: page 10]

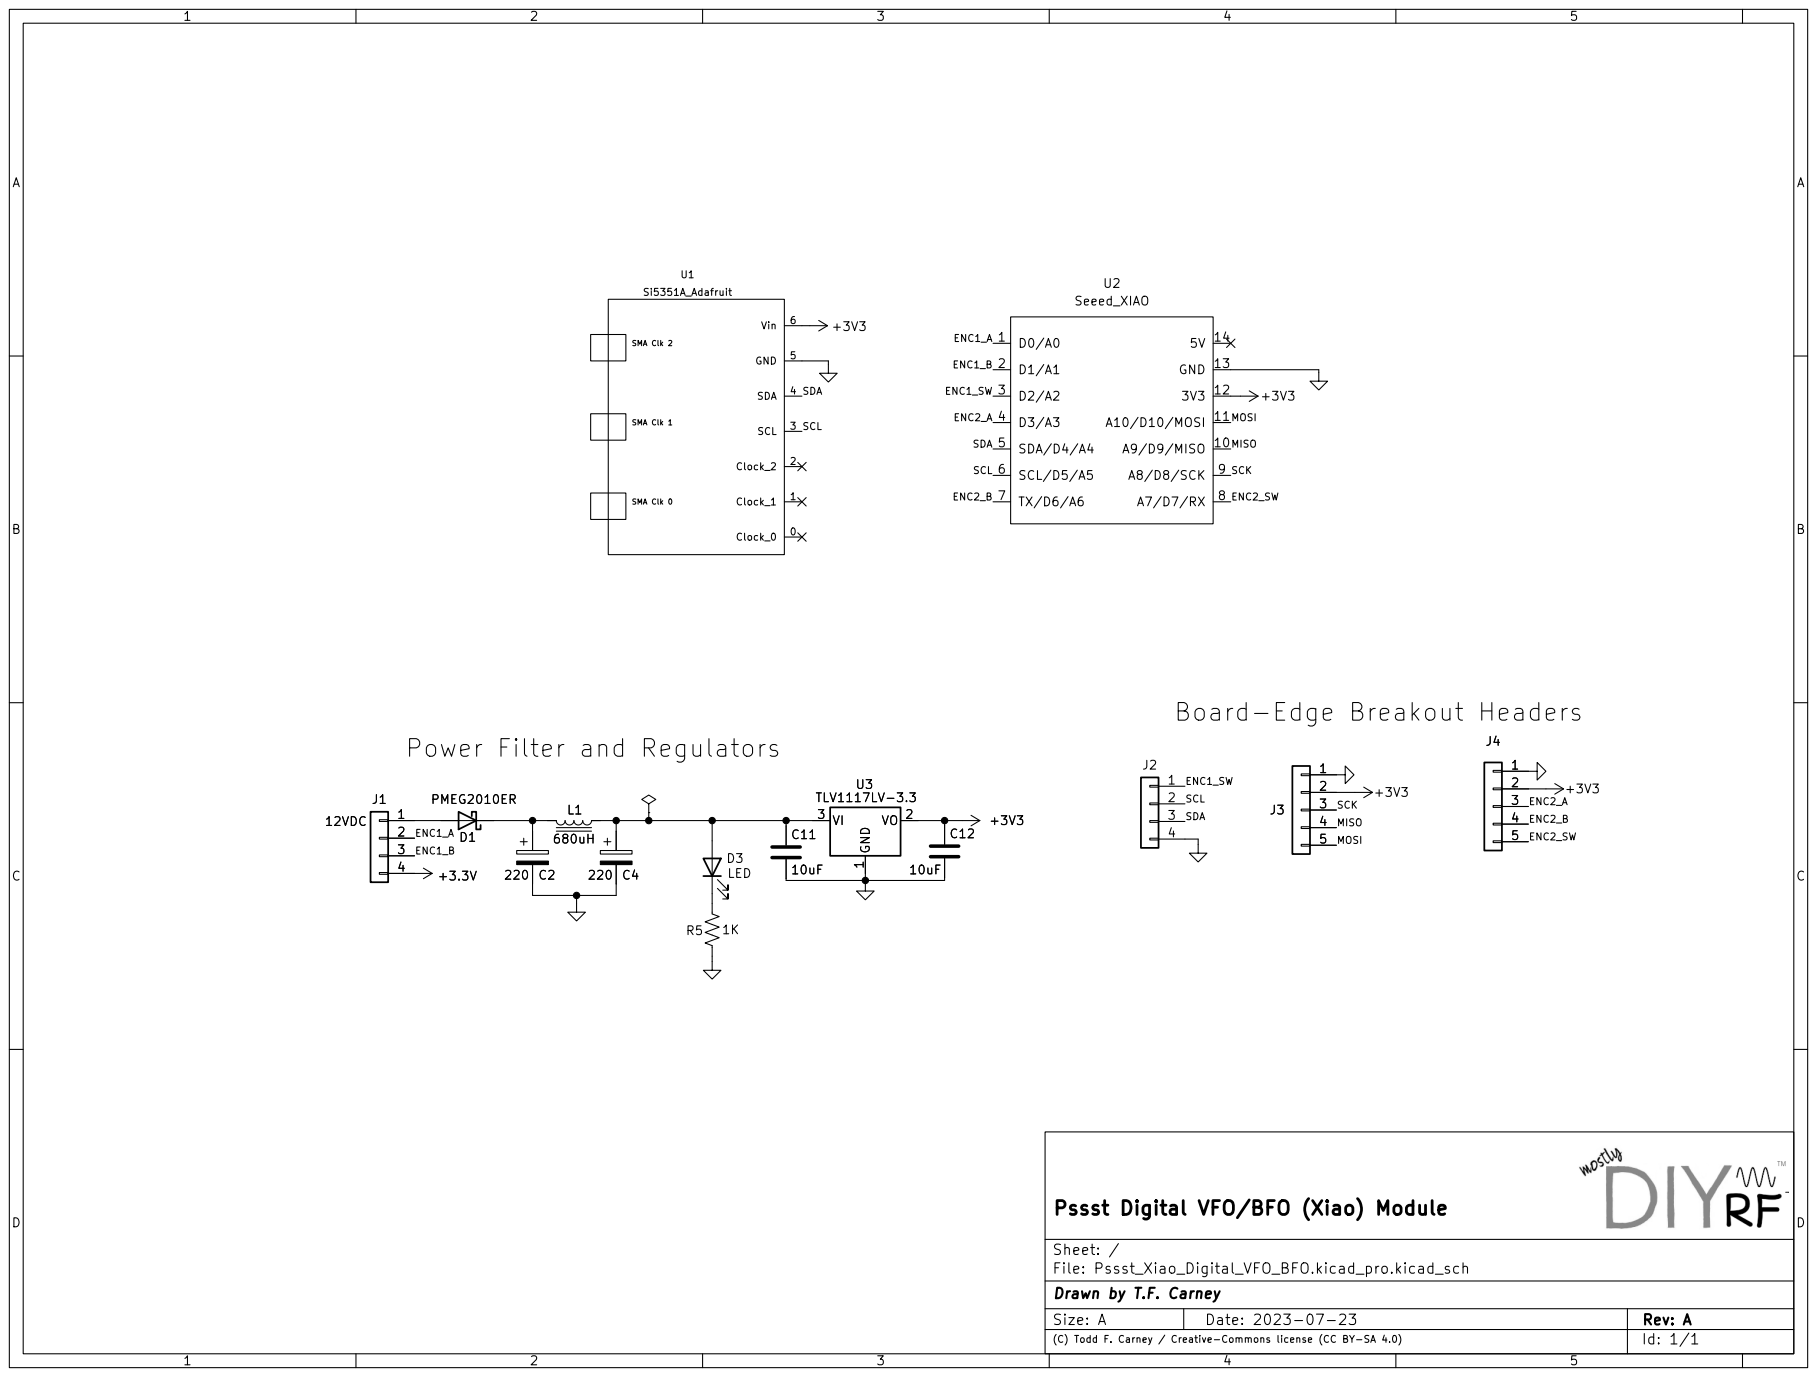
[picture p55: page 11]

1 VO 2 VI 3 U3 TLV1117LV-3.3 +3V3 D0/A0 1 A9/D9/MISO 10 A10/D10/MOSI 11

Id: 1/1 Drawn by T.F. Carney File: Pssst_Xiao_Digital_VFO_BFO.kicad_pro.kicad_sch Sheet: / Pssst Digital VFO/BFO (Xiao) Module
