mostlydiyrf/p3st/kicad/P3ST_motherboard_rev.C.pdf

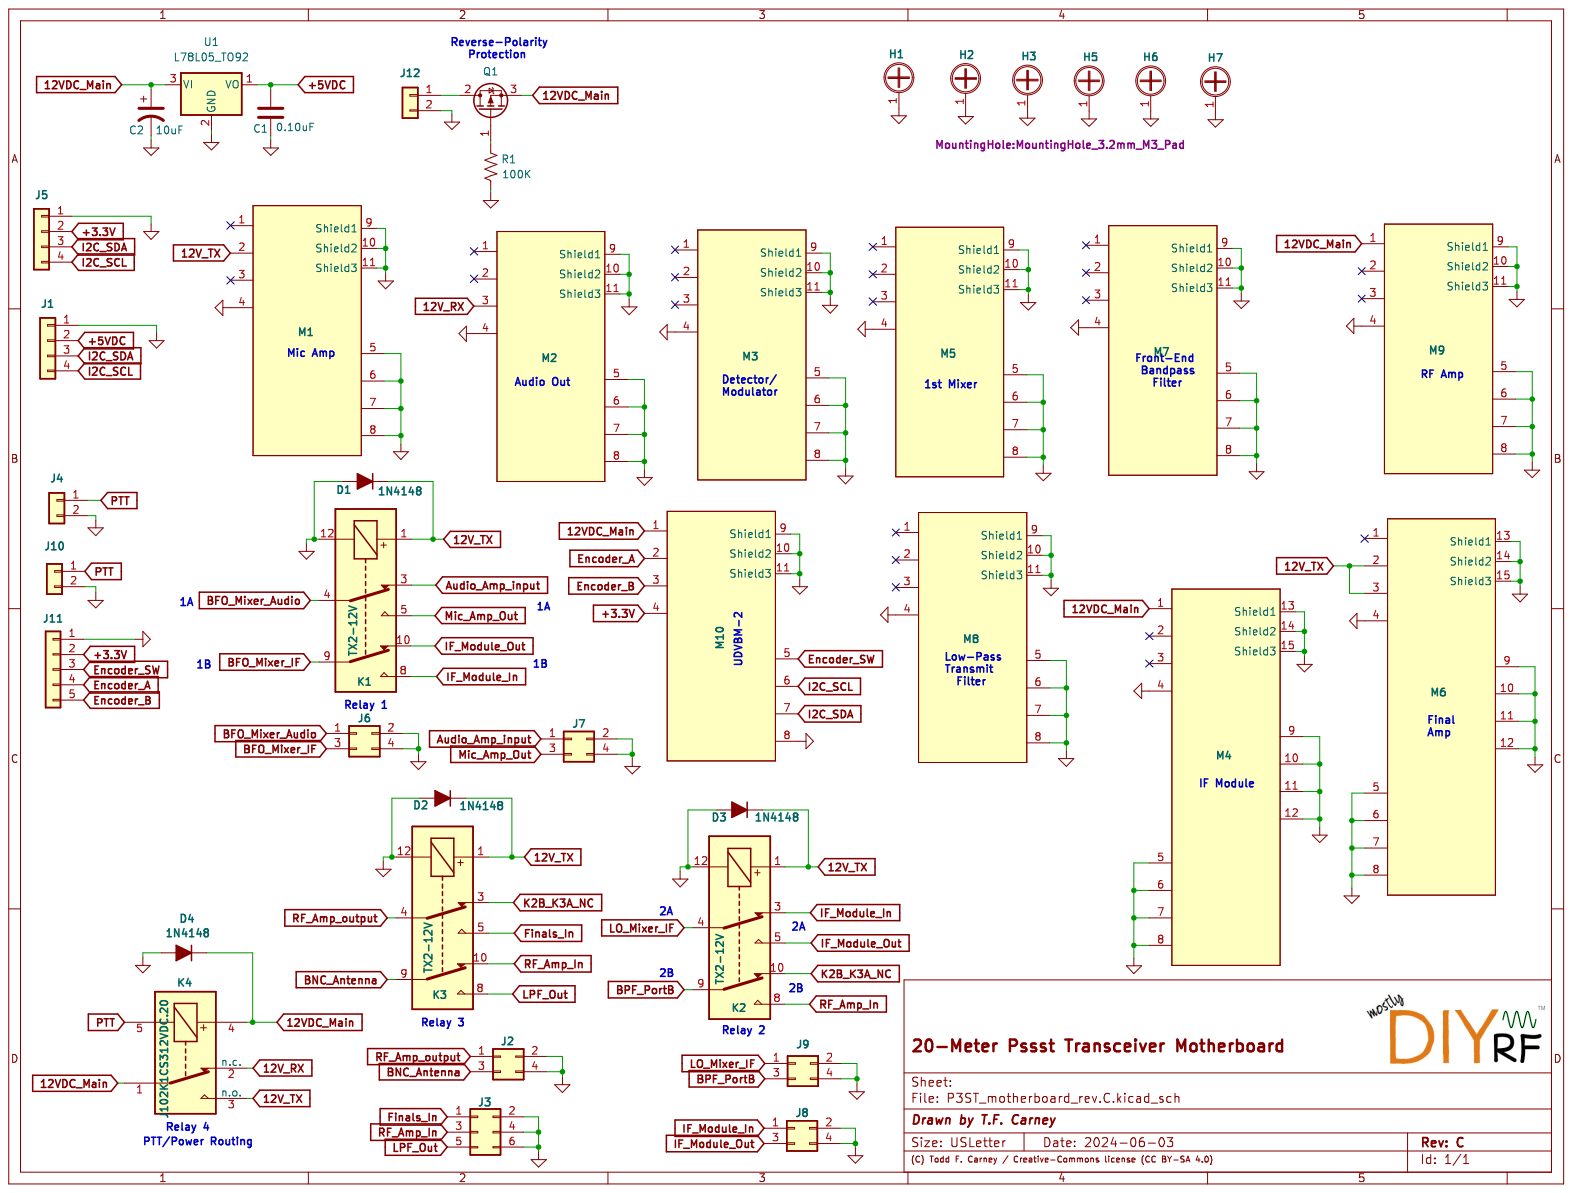
[picture p56: page 1]
