mostlydiyrf/p3st/LTspice/P3ST_20M_BPF.asc

C1: cap; 14.8pF
C2: cap; 1.5pF
C3: cap; 14.8pF
C4: cap; 39pF
C5: cap; 39pF
L1: ind; 2.304µH
L2: ind; 2.304µH
R1: res; 50
V1: voltage; SINE(); AC 1; Rser=50
Named nets: 0
.ac lin 1000 500000 29000000
L1,L2 = 24 Turns on a T-50-6 core - 2.304uH  Al = 40
