mostlydiyrf/p3st/LTspice/P3ST_Final_Driver.asc

C1: cap; 10nF
C2: cap; 100nF
C3: cap; 4.7nF
C4: cap; 100nF
C5: cap; 100nF
L2: ind2; 9.5µH
Q1: npn2; 2N2219A
R1: res; 2.7K
R2: res; 680
R3: res; 2.7K
R4: res; 10
R7: res; 10
R8: res; 50
V1: voltage; SINE(); AC 1.1; Rser=50
V2: voltage; 13.8
Named nets: 0, V2, V1
.ac oct 1000 1000000 200000000
9.5 Uh = 5 turns on a FT -37 -43 core
Driver Amp
R8 is not installed; Simulated Load
