mostlydiyrf/p3st/LTspice/P3ST_IF_Module.asc

3.3K: res; 680
C1: cap; 100nF
C2: cap; 100nF
C3: cap; 100nF
C4: cap; 100nF
C5: cap; 100nF
C6: cap; 100nF
C7: cap; 100nF
C8: cap; 100nF
C9: cap; 100nF
C10: cap; 10nF
C11: cap; 10nF
L1: ind2; 126.53µH
L2: ind2; 12.6µH
L3: ind2; 12.6µH
L4: ind2; 126.35µH
L5: ind; 12.6µH
Q1: npn; 2N2222
Q2: npn; 2N2222
R1: res; 100
R3: res; 3K
R4: res; 1K
R5: res; 10
R6: res; 500
R7: res; 1K
R8: res; 680
R9: res; 3.3K
R10: res; 50
R11: res; 10
R12: res; 50
V1: voltage; 12
V2: voltage; SINE(); AC 1; Rser=50
Named nets: 0, Vout, Vin
.ac lin 1000 100000 21000000
K2 L3 L4 1
L3 = 6 T Primary with L4 =19T Secondary #26 FT-37-43
K5 L1 L2 1
GQRP Filter Zi/out 500 Ohms goes here
19T Primary with 6T secondary #26 FT-37-43
