mostlydiyrf/p3st/LTspice/P3ST_Mic_Amp.asc

C1: cap; 100µF
C2: cap; 470µF
C3: cap; 10µF
C4: cap; .22µF
C5: cap; 22µF
C6: cap; .22µF
C7: cap; .22µF
Q1: npn; 2N2222
R1: res; 47K
R2: res; 100K
R3: res; 100
R4: res; 1K
R5: res; 2.2K
R6: res; 2.5K
R7: res; 2.5K
R8: res; 5K
V1: voltage; 12
V2: voltage; SINE(0); AC 1; Rser=1k
Named nets: 0
.ac lin 10000 20 20000
+
Microphone Pre-Amplifier
R6-R8 = 10K Pot --taps simulate output settings
