mostlydiyrf/p3st/LTspice/P3ST_W3NQN_20M_LPF.asc

C1: cap; 220pF
C2: cap; 330pF
C3: cap; 330pF
C4: cap; 220pF
C5: cap; 47pF
L1: ind; 0.670µH
L2: ind; 0.608µH
L3: ind; 0.670µH
R1: res; 50
V1: voltage; SINE(); AC 1; Rser=50
Named nets: 0
.ac lin 10000 100 100000000
L1,L3 = 13 Turns #26 on a T-60-6 Core
L2 = 12 Turns on a T-50-6 Core
W3NQN LPF for 20M
