mostlydiyrf/p3st/kicad/P3ST_motherboard_rev.C.kicad_pcb

## KiCad design kicad/P3ST_motherboard_rev.C.kicad_pcb (2025-12-27)

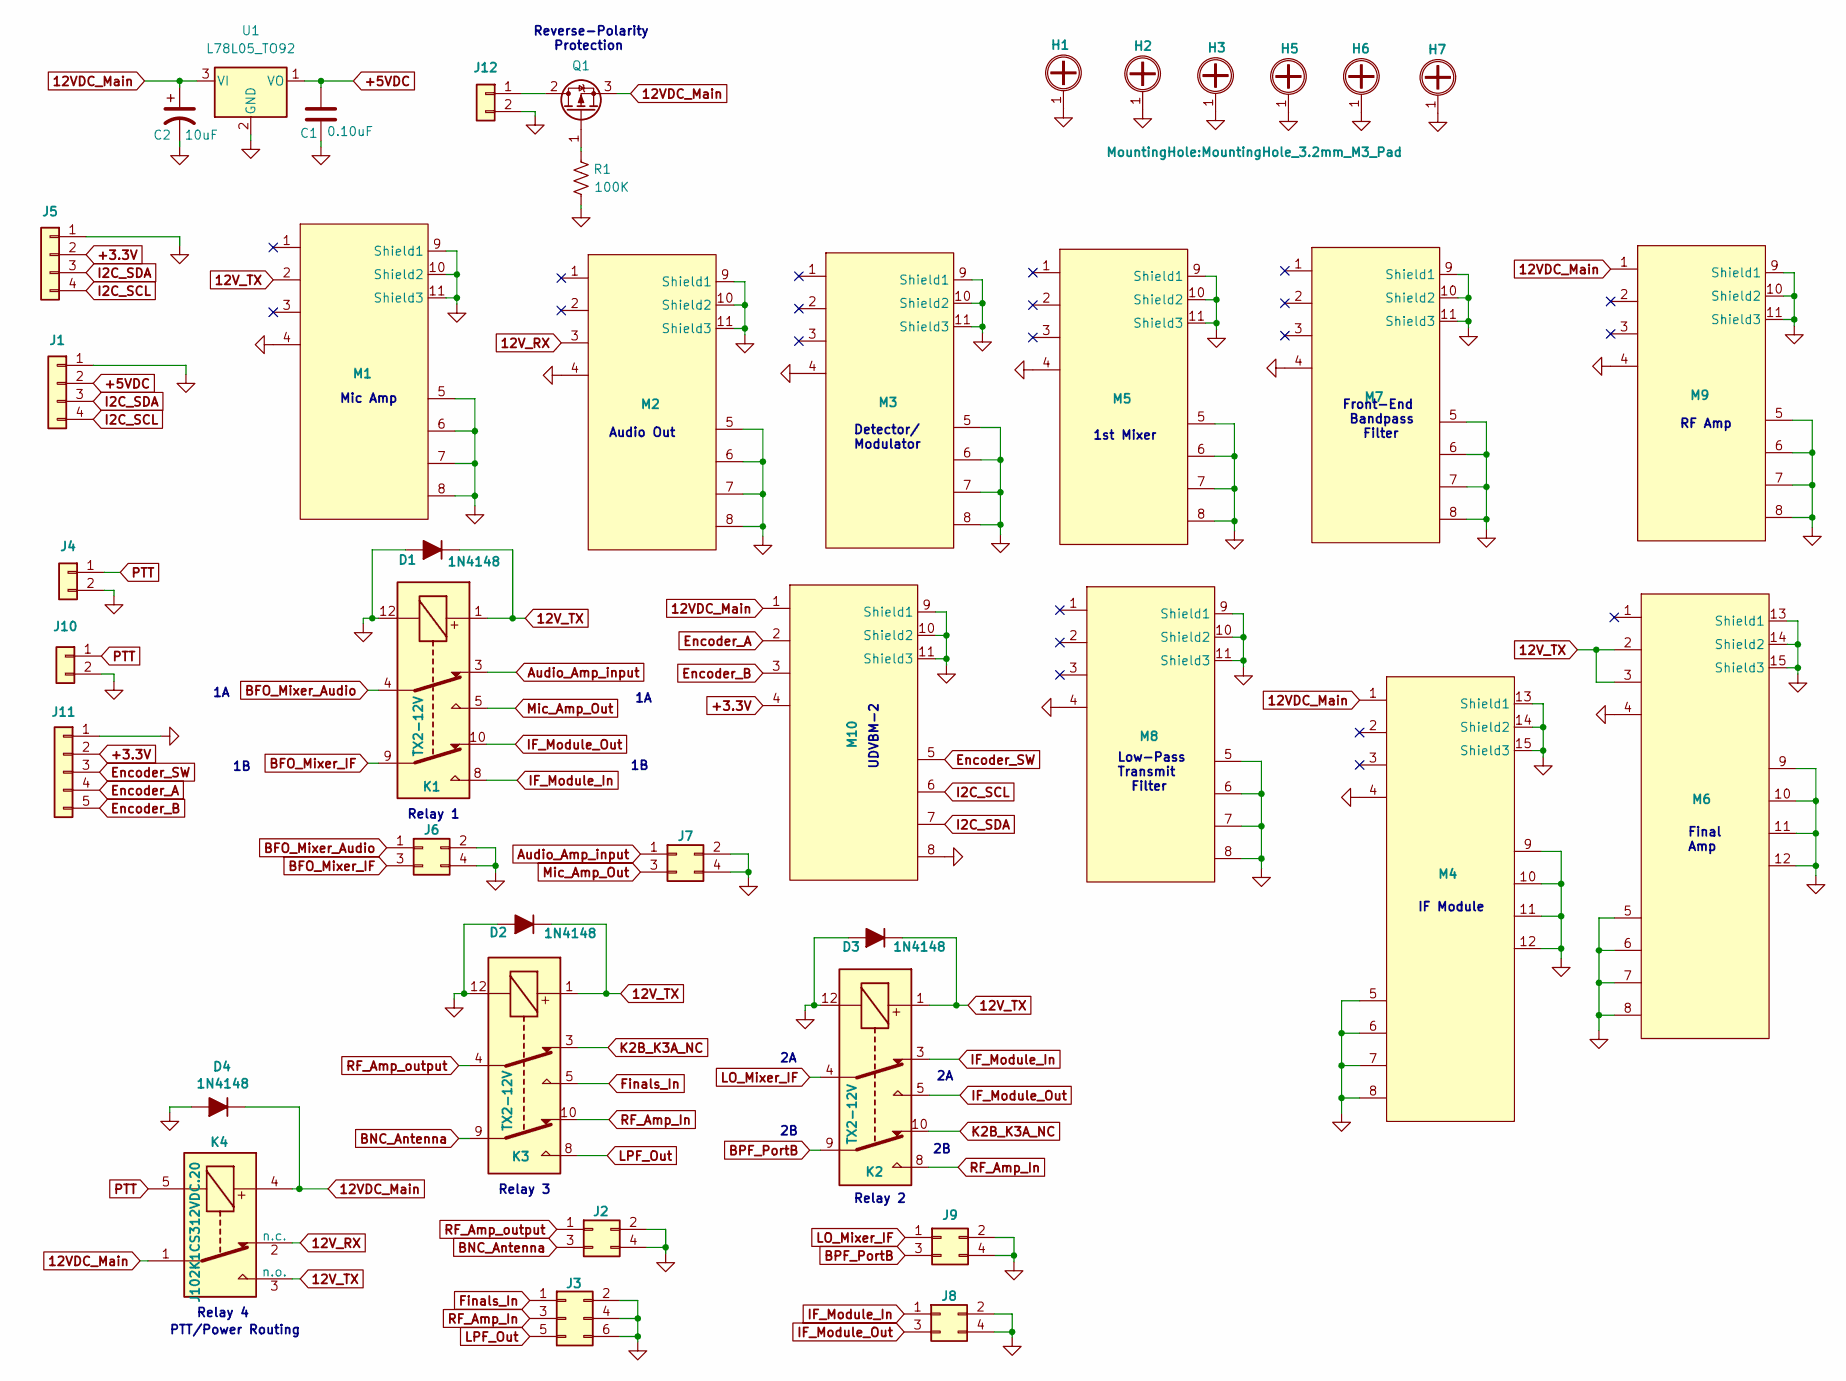
[picture p57: schematic P3ST_motherboard_rev.C.kicad_sch, 20-Meter Pssst Transceiver Motherboard]

Parts:
C1: 0.10uF; Ceramic_Disk_Capacitor_P5.00mm
C2: 10uF; CP_Radial_D6.3mm_P2.50mm
D1, D2, D3, D4: 1N4148; D_DO-35_SOD27_P7.62mm_Horizontal
H1, H2, H3, H5, H6, H7: Mounting_Hole_4-40; MountingHole_3.2mm_M3_Pad
J1, J5: Conn_01x04; PinHeader_1x04_P2.54mm_Vertical
J2, J6, J7, J8, J9: Conn_02x02_Odd_Even; RG274_2x2_HS
J3: Conn_02x03_Odd_Even; RG274_2x3_HS
J4, J10, J12: Conn_01x02; PinHeader_1x02_P2.54mm_Vertical
J11: Conn_01x05; PinHeader_1x05_P2.54mm_Vertical
K1, K2, K3: TX2-12V; RELAY_TX2_PAN
K4: J102K1CS312VDC.20; J102K-1C
M1, M2, M7, M8, M9, M10: StandardModule_1; K7TFC_CircuitBlock_Module1
M3, M5: StandardModule_1; K7TFC_CircuitBlock_Half_Module1
M4, M6: StandardModule_2; K7TFC_CircuitBlock_Module2
Q1: MOSFET_P_Channel_GDS; TO-220-3_Vertical
R1: 100K; Resistor_Quarter_Watt_P10.16mm_Horizontal
U1: L78L05_TO92; TO-92_Inline

Connections:
12VDC_Main: C2.1, D4.1 (K), K4.1, K4.4, M4.1, M9.1, M10.1, Q1.3 (S), U1.3 (VI)
12V_RX: K4.2 (n.c.), M2.3
12V_TX: D1.1 (K), D2.1 (K), D3.1 (K), K1.1, K2.1, K3.1, K4.3 (n.o.), M1.2, M6.2, M6.3
+3.3V: J5.2, J11.2, M10.4
+5VDC: C1.1, J1.2, U1.1 (VO)
Audio_Amp_input: J7.1, K1.3
BFO_Mixer_Audio: J6.1, K1.4
BFO_Mixer_IF: J6.3, K1.9
BNC_Antenna: J2.3, K3.9
BPF_PortB: J9.3, K2.9
Encoder_A: J11.4, M10.2
Encoder_B: J11.5, M10.3
Encoder_SW: J11.3, M10.5
Finals_In: J3.1, K3.5
GND: C1.2, C2.2, D1.2 (A), D2.2 (A), D3.2 (A), D4.2 (A), H1.1, H2.1, H3.1, H5.1, H6.1, H7.1, J1.1, J2.2, J2.4, J3.2, J3.4, J3.6, J4.2, J5.1, J6.2, J6.4, J7.2, J7.4, J8.2, J8.4, J9.2, J9.4, J10.2, J11.1, J12.2, K1.12, K2.12, K3.12, M1.4, M1.5, M1.6, M1.7, M1.8, M1.9 (Shield1), M1.10 (Shield2), M1.11 (Shield3), M2.4, M2.5, M2.6, M2.7, M2.8, M2.9 (Shield1), M2.10 (Shield2), M2.11 (Shield3), M3.4, M3.5, M3.6, M3.7, M3.8, M3.9 (Shield1), M3.10 (Shield2), M3.11 (Shield3), M4.4, M4.5, M4.6, M4.7, M4.8, M4.9, M4.10, M4.11, M4.12, M4.13 (Shield1), M4.14 (Shield2), M4.15 (Shield3), M5.4, M5.5, M5.6, M5.7, M5.8, M5.9 (Shield1), M5.10 (Shield2), M5.11 (Shield3), M6.4, M6.5, M6.6, M6.7, M6.8, M6.9, M6.10, M6.11, M6.12, M6.13 (Shield1), M6.14 (Shield2), M6.15 (Shield3), M7.4, M7.5, M7.6, M7.7, M7.8, M7.9 (Shield1), M7.10 (Shield2), M7.11 (Shield3), M8.4, M8.5, M8.6, M8.7, M8.8, M8.9 (Shield1), M8.10 (Shield2), M8.11 (Shield3), M9.4, M9.5, M9.6, M9.7, M9.8, M9.9 (Shield1), M9.10 (Shield2), M9.11 (Shield3), M10.8, M10.9 (Shield1), M10.10 (Shield2), M10.11 (Shield3), R1.2, U1.2 (GND)
I2C_SCL: J1.4, J5.4, M10.6
I2C_SDA: J1.3, J5.3, M10.7
IF_Module_In: J8.1, K1.8, K2.3
IF_Module_Out: J8.3, K1.10, K2.5
K2B_K3A_NC: K2.10, K3.3
LO_Mixer_IF: J9.1, K2.4
LPF_Out: J3.5, K3.8
Mic_Amp_Out: J7.3, K1.5
unnamed: J12.1, Q1.2 (D)
unnamed: Q1.1 (G), R1.1
PTT: J4.1, J10.1, K4.5
RF_Amp_In: J3.3, K2.8, K3.10
RF_Amp_output: J2.1, K3.4

Notes on the sheet:
Relay 3
1st Mixer
Front-End Bandpass Filter
Audio Out
Relay 1
PTT/Power Routing
Final Amp
Mic Amp
Detector/ Modulator
UDVBM-2
RF Amp
Relay 4
IF Module
Reverse-Polarity Protection
Low-Pass Transmit Filter
Relay 2

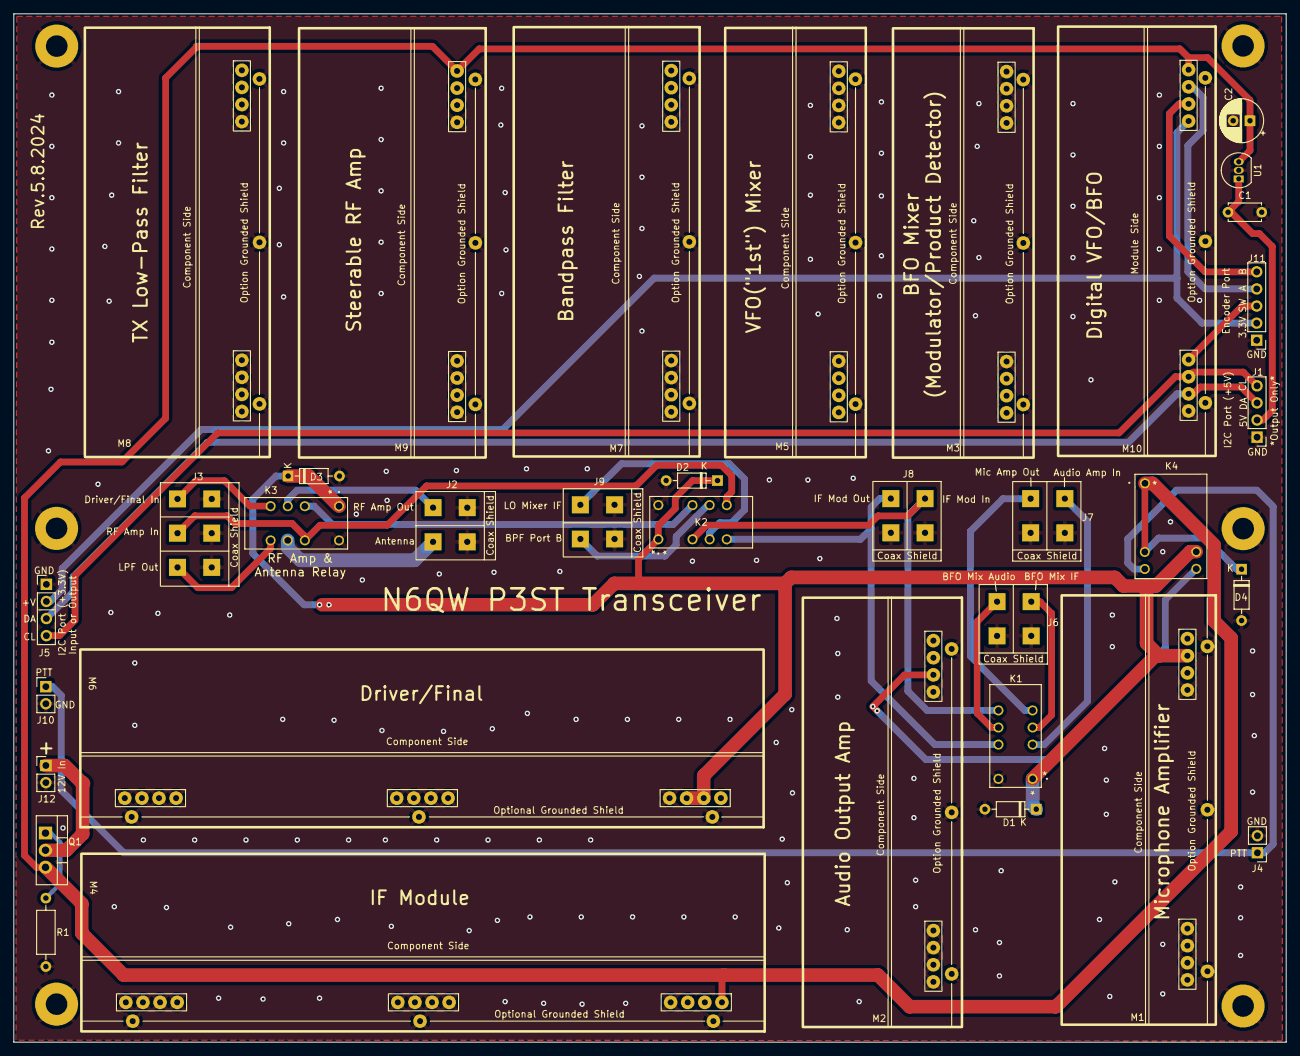
[picture p58: board P3ST_motherboard_rev.C.kicad_pcb from above]

Board: 2 copper layers, 188.9 x 152.7 mm, 41 parts (0 on the bottom side), 28 nets.
