mostlydiyrf/p3st/kicad/Pssst_TX_final_amp.kicad_pcb

## KiCad design kicad/Pssst_TX_final_amp.kicad_pcb (2024-02-04)

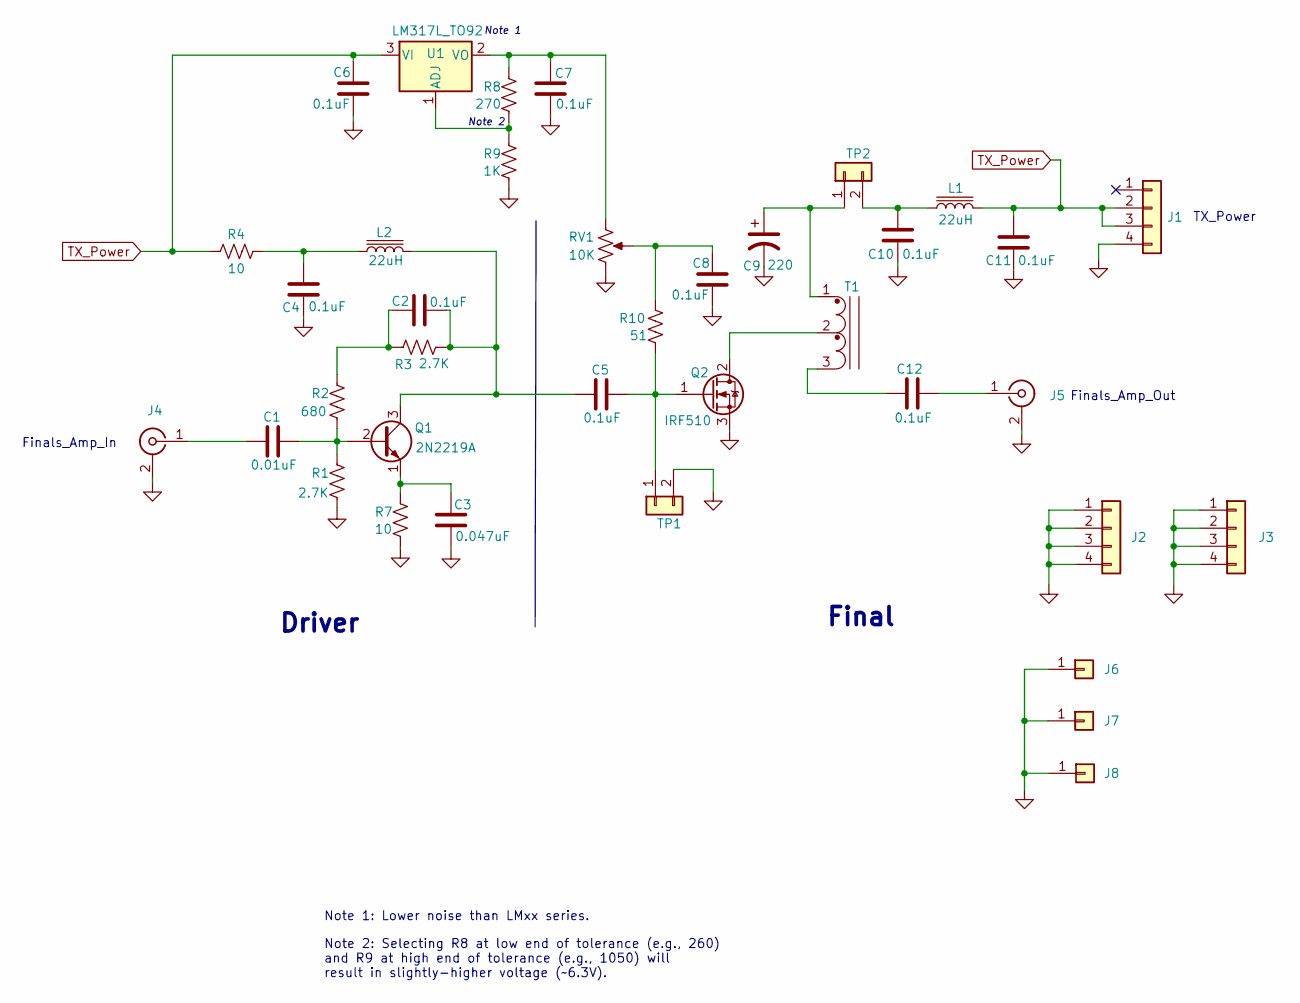
[picture p59: schematic Pssst_TX_final_amp.kicad_sch, Pssst Final TX Amplifier]

Parts:
C1: 0.01uF; Ceramic_Disk_Capacitor_P5.00mm
C2, C4, C5, C6, C7, C8, C10, C11, C12: 0.1uF; Ceramic_Disk_Capacitor_P5.00mm
C3: 0.047uF; Ceramic_Disk_Capacitor_P5.00mm
C9: 220; CP_Radial_D5.0mm_P2.50mm
J1, J2, J3: Conn_01x04; PinHeader_1x04_P2.54mm_Vertical
J4, J5: Phono_Jack_RCA; SMA_EdgeMount_0.062_Samtec_wHoles
J6, J7, J8: Conn_01x01; PinHeader_1x01_P2.54mm_Vertical
L1: 22uH; L_Radial_D8.7mm_P5.00mm_Fastron_07HCP
L2: 22uH; L_Axial_L11.0mm_D4.5mm_P15.24mm_Horizontal_Fastron_MECC
Q1: 2N2219A; TO-39-3
Q2: IRF510; TO-220-3_Vertical
R1, R3: 2.7K; Resistor_Quarter_Watt_P10.16mm_Horizontal
R2: 680; Resistor_Quarter_Watt_P10.16mm_Horizontal
R4, R7: 10; Resistor_Quarter_Watt_P10.16mm_Horizontal
R8: 270; Resistor_Quarter_Watt_P10.16mm_Horizontal
R9: 1K; Resistor_Quarter_Watt_P10.16mm_Horizontal
R10: 51; Resistor_Quarter_Watt_P10.16mm_Horizontal
RV1: 10K; POT_Bourns_3362P
T1: Transformer_Bifilar_CT_Toroid; Toroid_Transformer_Bifilar_T50_Vertical_P2.54mm
TP1, TP2: Conn_01x02; PinHeader_1x02_P2.54mm_Vertical
U1: LM317L_TO92; TO-92_Inline

Connections:
GND: C3.1, C4.2, C6.2, C7.2, C8.2, C9.2, C10.2, C11.2, J1.4, J2.1, J2.2, J2.3, J2.4, J3.1, J3.2, J3.3, J3.4, J4.2 (Ext), J5.2 (Ext), J6.1, J7.1, J8.1, Q2.3 (S), R1.2, R7.2, R9.2, RV1.3, TP1.2
unnamed: C1.1, Q1.2 (B), R1.1, R2.2
unnamed: C1.2, J4.1 (In)
unnamed: C2.1, R2.1, R3.1
unnamed: C2.2, C5.2, L2.2, Q1.3 (C), R3.2
unnamed: C3.2, Q1.1 (E), R7.1
unnamed: C4.1, L2.1, R4.2
unnamed: C5.1, Q2.1 (G), R10.2, TP1.1
unnamed: C7.1, R8.1, RV1.1, U1.2 (VO)
unnamed: C8.1, R10.1, RV1.2
unnamed: C9.1, T1.1 (PR1), TP2.1
unnamed: C10.1, L1.1, TP2.2
unnamed: C12.1, T1.3 (PR2)
unnamed: C12.2, J5.1 (In)
unnamed: Q2.2 (D), T1.2 (PM)
unnamed: R8.2, R9.1, U1.1 (ADJ)
TX_Power: C6.1, C11.1, J1.2, J1.3, L1.2, R4.1, U1.3 (VI)

Notes on the sheet:
Driver
Note 2
Note 2: Selecting R8 at low end of tolerance (e.g., 260) and R9 at high end of tolerance (e.g., 1050) will result in slightly-higher voltage (~6.3V).
Finals_Amp_Out
Finals_Amp_In
Final
Note 1: Lower noise than LMxx series.
Note 1
TX_Power

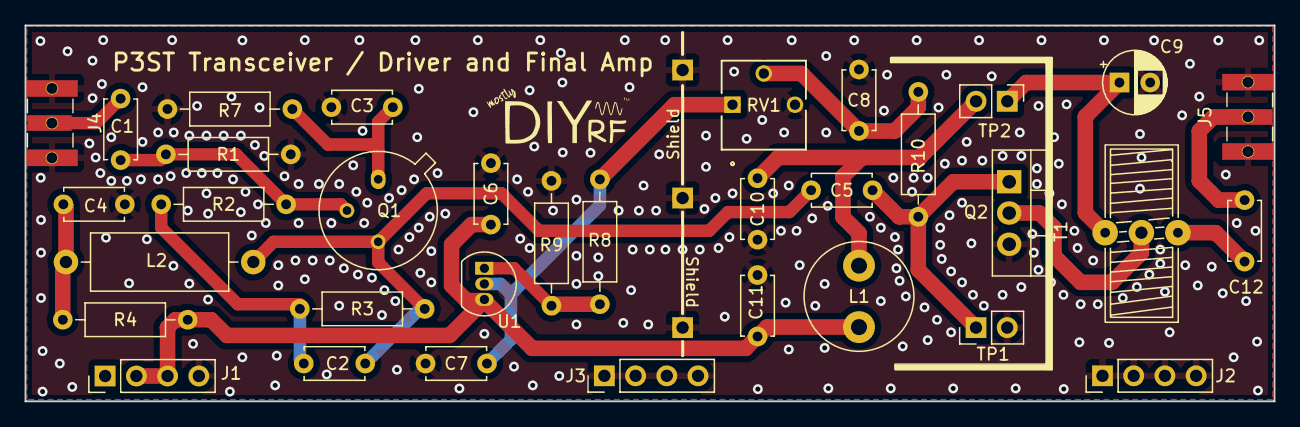
[picture p60: board Pssst_TX_final_amp.kicad_pcb from above]

Board: 2 copper layers, 101.6 x 30.6 mm, 37 parts (0 on the bottom side), 17 nets.
