mostlydiyrf/p3st/kicad/Pssst_IF_module.kicad_pcb

## KiCad design kicad/Pssst_IF_module.kicad_pcb (2024-02-04)

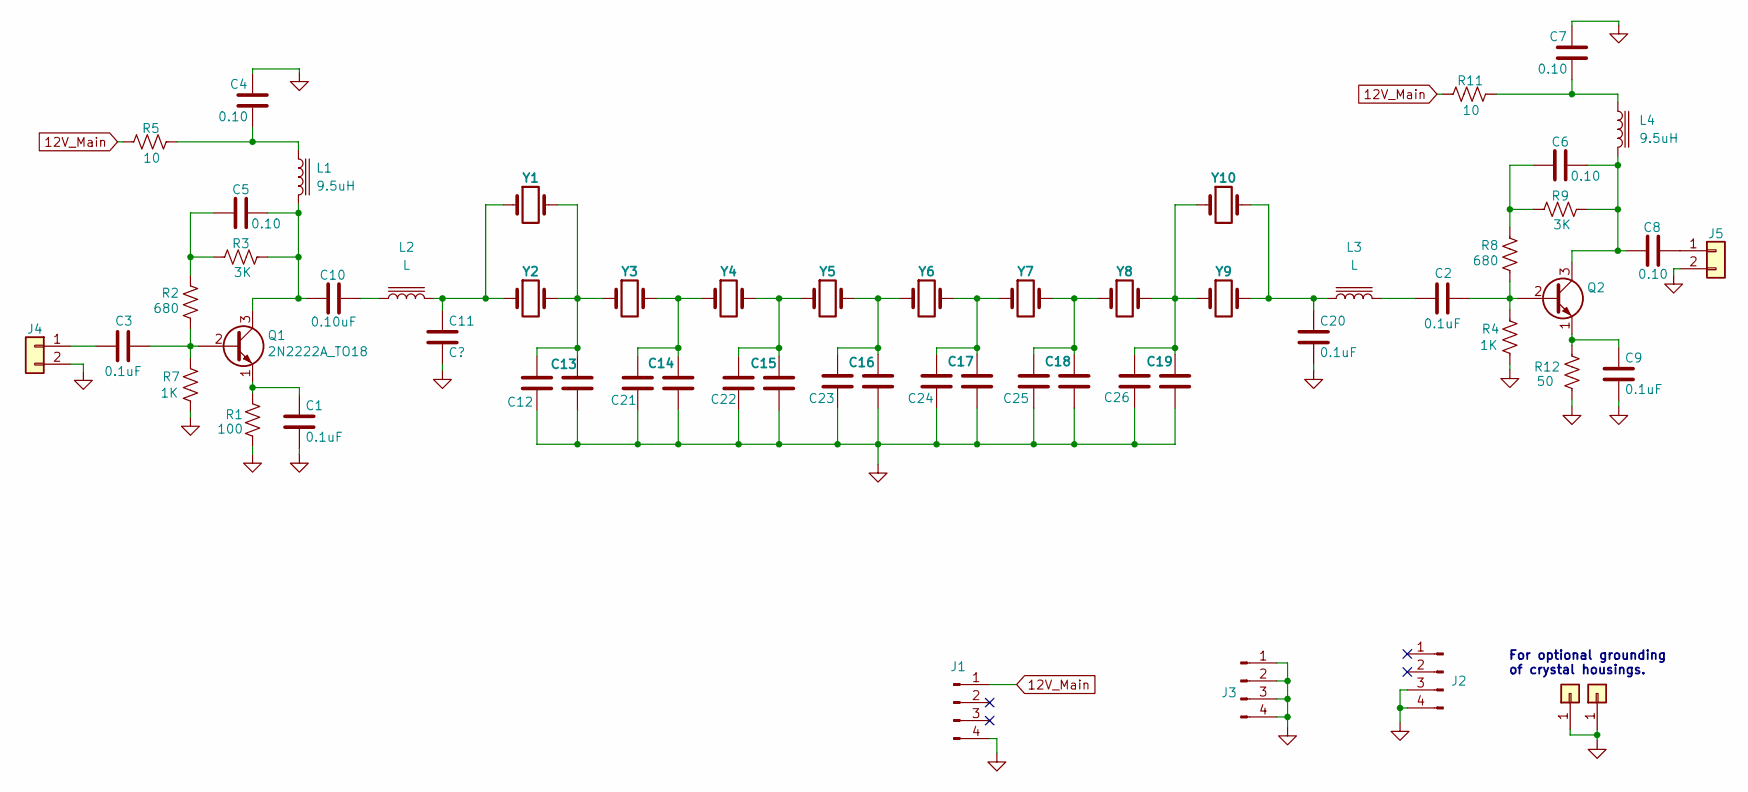
[picture p61: schematic Pssst_IF_module.kicad_sch]

Parts:
C1, C2, C3, C9, C20: 0.1uF; C_Disc_D3.4mm_W2.1mm_P2.50mm
C4, C5, C6, C7, C8: 0.10; C_Disc_D3.4mm_W2.1mm_P2.50mm
C10: 0.10uF; C_Disc_D3.4mm_W2.1mm_P2.50mm
C11: C?; C_Disc_D3.4mm_W2.1mm_P2.50mm
C12, C21, C22, C23, C24, C25, C26: C; Cap_ParallelPads_Righthand_P2.50mm
C13, C14, C15, C16, C17, C18, C19: C; C_Disc_D3.4mm_W2.1mm_P2.50mm
J1, J2, J3: Conn_01x04_Male; PinHeader_1x04_P2.54mm_Vertical
J4, J5: Conn_01x02; SMA_EdgeMount_0.062_Samtec_wHoles
J6, J7: Conn_01x01; PinHeader_1x01_P2.54mm_Vertical
L1, L4: 9.5uH; L_Axial_L11.0mm_D4.5mm_P7.62mm_Vertical_Fastron_MECC
L2, L3: L; Toroid_T50_Vertical_P6.00mm
Q1, Q2: 2N2222A_TO18; TO-18-3
R1: 100; R_Axial_P2.54mm_Vertical
R2, R8: 680; R_Axial_P2.54mm_Vertical
R3, R9: 3K; R_Axial_P2.54mm_Vertical
R4, R7: 1K; R_Axial_P2.54mm_Vertical
R5, R11: 10; R_Axial_P2.54mm_Vertical
R12: 50; R_Axial_P2.54mm_Vertical
Y1, Y2, Y3, Y4, Y5, Y6, Y7, Y8, Y9, Y10: Crystal; Crystal_HC49-U_Vertical

Connections:
12V_Main: J1.1, R5.1, R11.1
GND: C1.2, C4.2, C7.2, C9.2, C11.2, C12.2, C13.2, C14.2, C15.2, C16.2, C17.2, C18.2, C19.2, C20.2, C21.2, C22.2, C23.2, C24.2, C25.2, C26.2, J1.4, J2.3, J2.4, J3.1, J3.2, J3.3, J3.4, J4.2, J5.2, J6.1, J7.1, R1.2, R4.2, R7.2, R12.2
unnamed: C1.1, Q1.1 (E), R1.1
unnamed: C2.1, L3.2
unnamed: C2.2, Q2.2 (B), R4.1, R8.2
unnamed: C3.1, J4.1
unnamed: C3.2, Q1.2 (B), R2.2, R7.1
unnamed: C4.1, L1.1, R5.2
unnamed: C5.2, R2.1, R3.1
unnamed: C6.1, C8.1, L4.2, Q2.3 (C), R9.2
unnamed: C6.2, R8.1, R9.1
unnamed: C7.1, L4.1, R11.2
unnamed: C8.2, J5.1
unnamed: C9.1, Q2.1 (E), R12.1
unnamed: C5.1, C10.1, L1.2, Q1.3 (C), R3.2
unnamed: C10.2, L2.1
unnamed: C11.1, L2.2, Y1.1, Y2.1
unnamed: C12.1, C13.1, Y1.2, Y2.2, Y3.1
unnamed: C14.1, C21.1, Y3.2, Y4.1
unnamed: C15.1, C22.1, Y4.2, Y5.1
unnamed: C16.1, C23.1, Y5.2, Y6.1
unnamed: C17.1, C24.1, Y6.2, Y7.1
unnamed: C18.1, C25.1, Y7.2, Y8.1
unnamed: C19.1, C26.1, Y8.2, Y9.1, Y10.1
unnamed: C20.1, L3.1, Y9.2, Y10.2

Notes on the sheet:
For optional grounding of crystal housings.

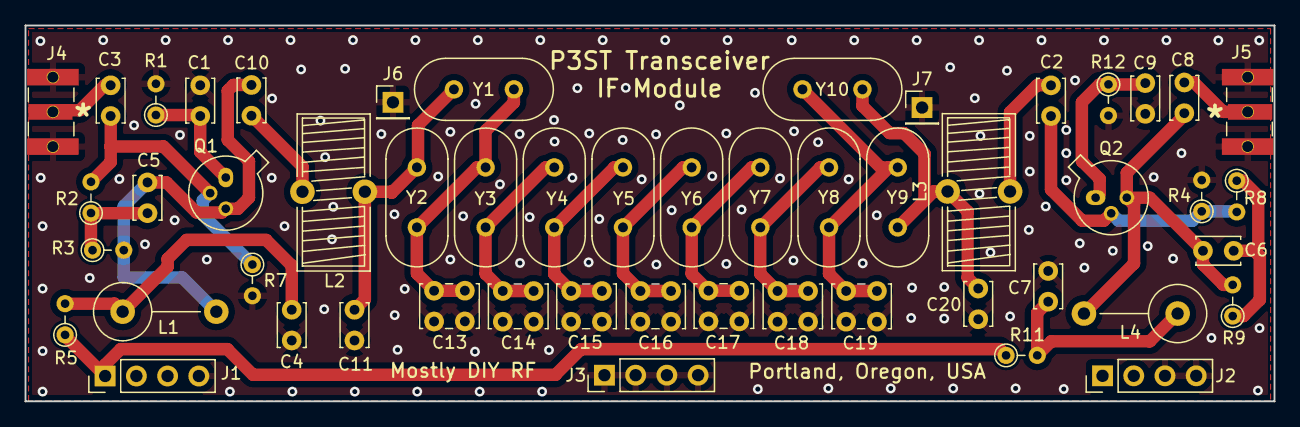
[picture p62: board Pssst_IF_module.kicad_pcb from above]

Board: 2 copper layers, 101.6 x 30.6 mm, 59 parts (0 on the bottom side), 25 nets.
