mostlydiyrf/p3st/kicad/Pssst_frontend_bandpass.kicad_pcb

## KiCad design kicad/Pssst_frontend_bandpass.kicad_pcb (2024-02-04)

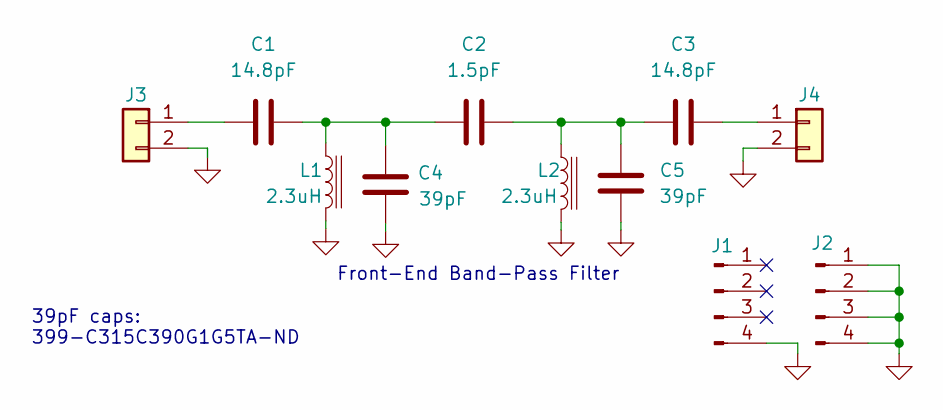
[picture p63: schematic Pssst_frontend_bandpass.kicad_sch, Pssst Frontend Bandpass Filter]

Parts:
C1, C3: 14.8pF; Capacitor_Trimmer_Ceramic_GKGxx015_Series
C2: 1.5pF; C_Gimmick
C4, C5: 39pF; Capacitor_Trimmer_Ceramic_GKGxx015_Series
J1, J2: Conn_01x04_Male; PinHeader_1x04_P2.54mm_Vertical
J3, J4: Conn_01x02; SMA_EdgeMount_0.062_Samtec_wHoles
L1, L2: 2.3uH; Toroid_T50_Vertical_P6.00mm

Connections:
GND: C4.2, C5.2, J1.4, J2.1, J2.2, J2.3, J2.4, J3.2, J4.2, L1.2, L2.2
unnamed: C1.1, J3.1
unnamed: C1.2, C2.1, C4.1, L1.1
unnamed: C2.2, C3.1, C5.1, L2.1
unnamed: C3.2, J4.1

Notes on the sheet:
Front-End Band-Pass Filter
39pF caps: 399-C315C390G1G5TA-ND

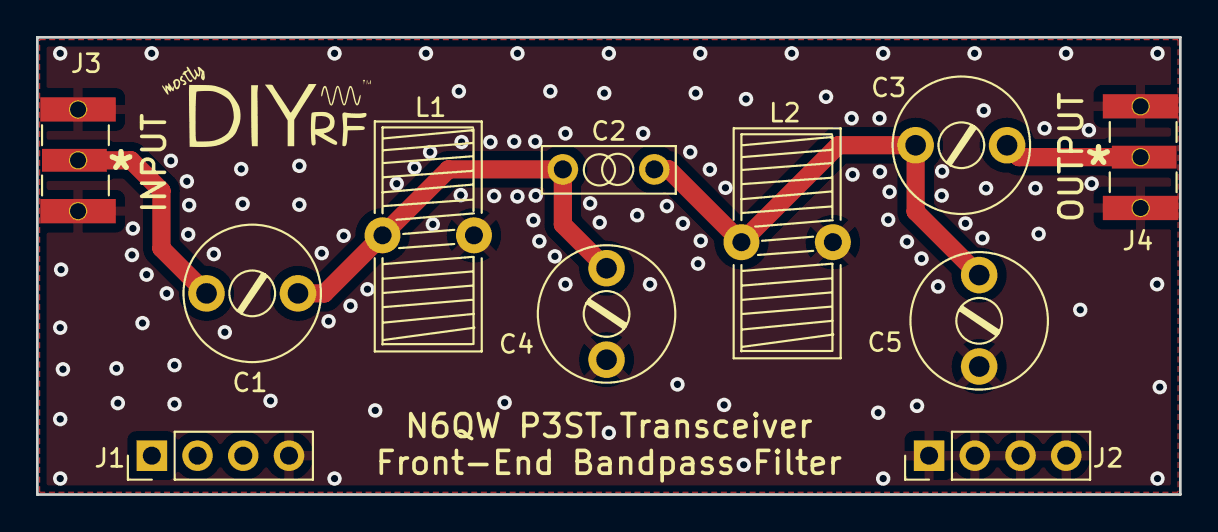
[picture p64: board Pssst_frontend_bandpass.kicad_pcb from above]

Board: 2 copper layers, 63.5 x 25.4 mm, 11 parts (0 on the bottom side), 5 nets.
