mostlydiyrf/p3st/kicad/Pssst_VFO_Mixer.kicad_pcb

## KiCad design kicad/Pssst_VFO_Mixer.kicad_pcb (2024-02-04)

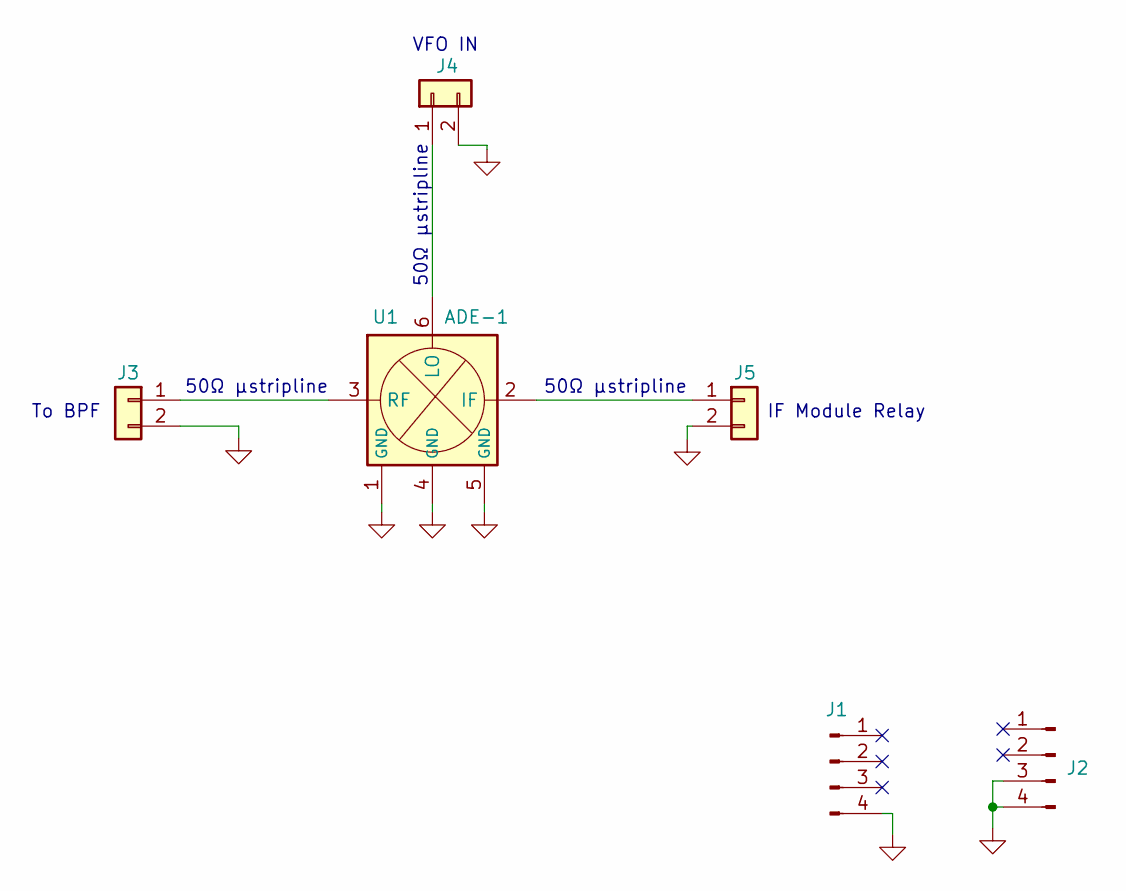
[picture p65: schematic Pssst_VFO_Mixer.kicad_sch, Pssst VFO Mixer]

Parts:
J1, J2: Conn_01x04_Male; PinHeader_1x04_P2.54mm_Vertical
J3, J4, J5: Conn_01x02; SMA_EdgeMount_0.062_Samtec_wHoles
U1: ADE-1; Mini-Circuits_ADE-1_CD636

Connections:
GND: J1.4, J2.3, J2.4, J3.2, J4.2, J5.2, U1.1 (GND), U1.4 (GND), U1.5 (GND)
unnamed: J3.1, U1.3 (RF)
unnamed: J4.1, U1.6 (LO)
unnamed: J5.1, U1.2 (IF)

Notes on the sheet:
IF Module Relay
50Ω μstripline
To BPF
VFO IN

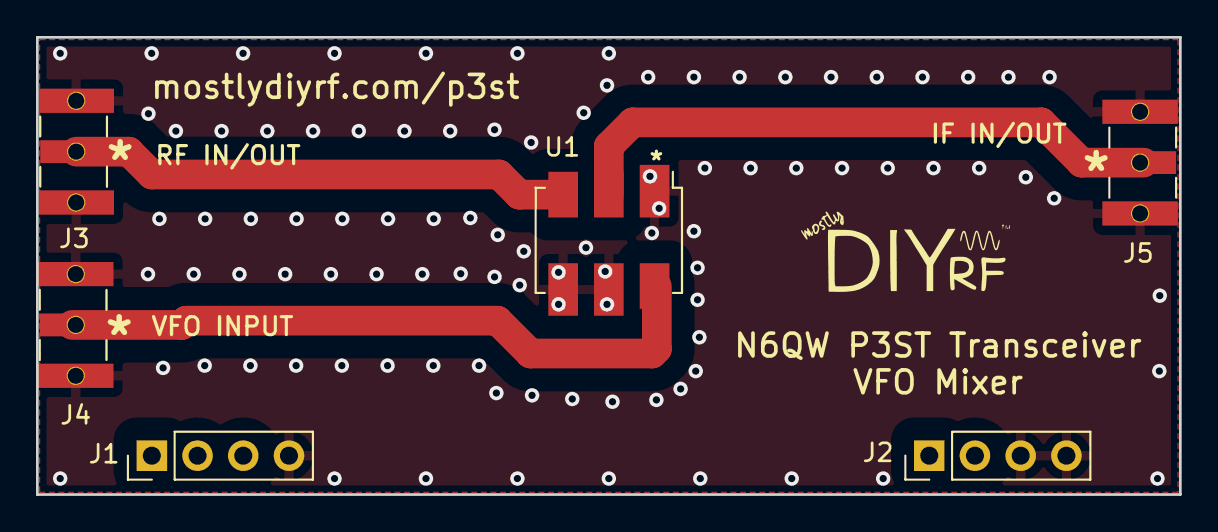
[picture p66: board Pssst_VFO_Mixer.kicad_pcb from above]

Board: 2 copper layers, 63.5 x 25.4 mm, 6 parts (0 on the bottom side), 4 nets.
