mostlydiyrf/p3st/kicad/Pssst_final_lowpass.kicad_pcb

## KiCad design kicad/Pssst_final_lowpass.kicad_pcb (2024-02-04)

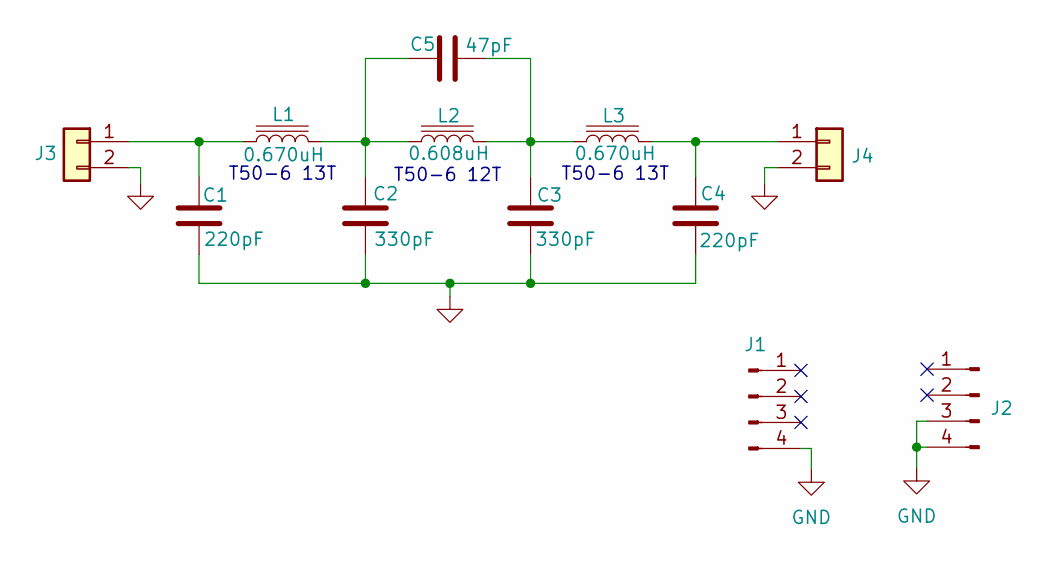
[picture p67: schematic Pssst_final_lowpass.kicad_sch, Pssst Final Low-Pass Filter]

Parts:
C1, C4: 220pF; Ceramic_Disk_Capacitor_P5.00mm
C2, C3: 330pF; Ceramic_Disk_Capacitor_P5.00mm
C5: 47pF; Ceramic_Disk_Capacitor_P5.00mm
J1, J2: Conn_01x04_Male; PinHeader_1x04_P2.54mm_horizontal
J3, J4: Conn_01x02; SMA_EdgeMount_0.062_Samtec_wHoles
L1, L3: 0.670uH; Toroid_T50_Vertical_P6.00mm
L2: 0.608uH; Toroid_T50_Vertical_P6.00mm

Connections:
GND: C1.2, C2.2, C3.2, C4.2, J1.4, J2.3, J2.4, J3.2, J4.2
unnamed: C1.1, J3.1, L1.1
unnamed: C2.1, C5.1, L1.2, L2.1
unnamed: C3.1, C5.2, L2.2, L3.1
unnamed: C4.1, J4.1, L3.2

Notes on the sheet:
T50-6 12T
T50-6 13T

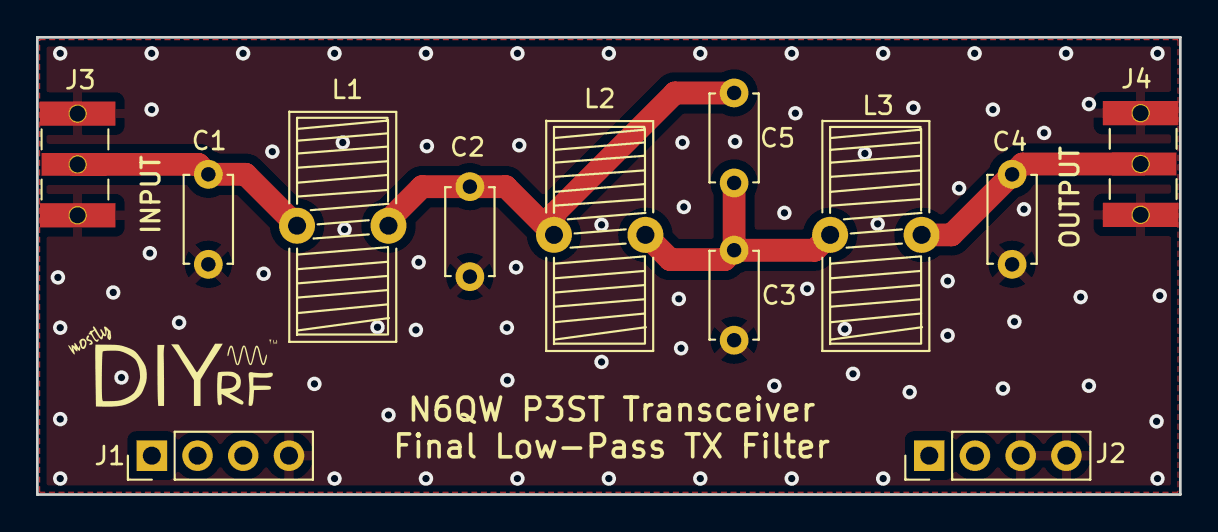
[picture p68: board Pssst_final_lowpass.kicad_pcb from above]

Board: 2 copper layers, 63.5 x 25.4 mm, 12 parts (0 on the bottom side), 5 nets.
