mostlydiyrf/p3st/kicad/Pssst_microphone_amp.kicad_pcb

## KiCad design kicad/Pssst_microphone_amp.kicad_pcb (2024-02-04)

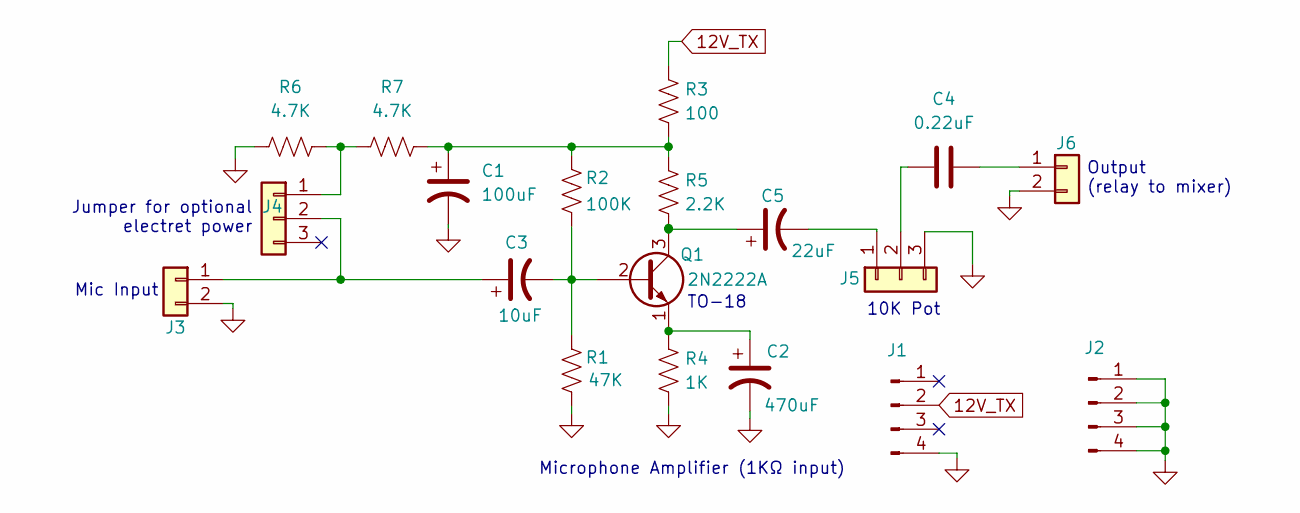
[picture p69: schematic Pssst_microphone_amp.kicad_sch, Pssst Microphone Amplifier]

Parts:
C1: 100uF; CP_Radial_D5.0mm_P2.00mm
C2: 470uF; CP_Radial_D8.0mm_P3.50mm
C3: 10uF; CP_Radial_D5.0mm_P2.00mm
C4: 0.22uF; C_Disc_D5.0mm_W2.5mm_P2.50mm
C5: 22uF; CP_Radial_D5.0mm_P2.00mm
J1, J2: Conn_01x04_Male; PinHeader_1x04_P2.54mm_Vertical
J3, J6: Conn_01x02; SMA_EdgeMount_0.062_Samtec_wHoles
J4, J5: Conn_01x03; PinHeader_1x03_P2.54mm_Vertical
Q1: 2N2222A; TO-18-3
R1: 47K; Resistor_Quarter_Watt_P10.16mm_Horizontal
R2: 100K; Resistor_Quarter_Watt_P10.16mm_Horizontal
R3: 100; Resistor_Quarter_Watt_P10.16mm_Horizontal
R4: 1K; Resistor_Quarter_Watt_P10.16mm_Horizontal
R5: 2.2K; Resistor_Quarter_Watt_P10.16mm_Horizontal
R6, R7: 4.7K; Resistor_Quarter_Watt_P10.16mm_Horizontal

Connections:
12V_TX: J1.2, R3.1
GND: C1.2, C2.2, J1.4, J2.1, J2.2, J2.3, J2.4, J3.2, J5.3, J6.2, R1.2, R4.2, R6.1
unnamed: C1.1, R2.1, R3.2, R5.1, R7.2
unnamed: C2.1, Q1.1 (E), R4.1
unnamed: C3.1, J3.1, J4.2
unnamed: C3.2, Q1.2 (B), R1.1, R2.2
unnamed: C4.1, J5.2
unnamed: C4.2, J6.1
unnamed: C5.1, Q1.3 (C), R5.2
unnamed: C5.2, J5.1
unnamed: J4.1, R6.2, R7.1

Notes on the sheet:
Jumper for optional electret power
10K Pot
Output (relay to mixer)
Microphone Amplifier (1KΩ input)
Mic Input
TO-18

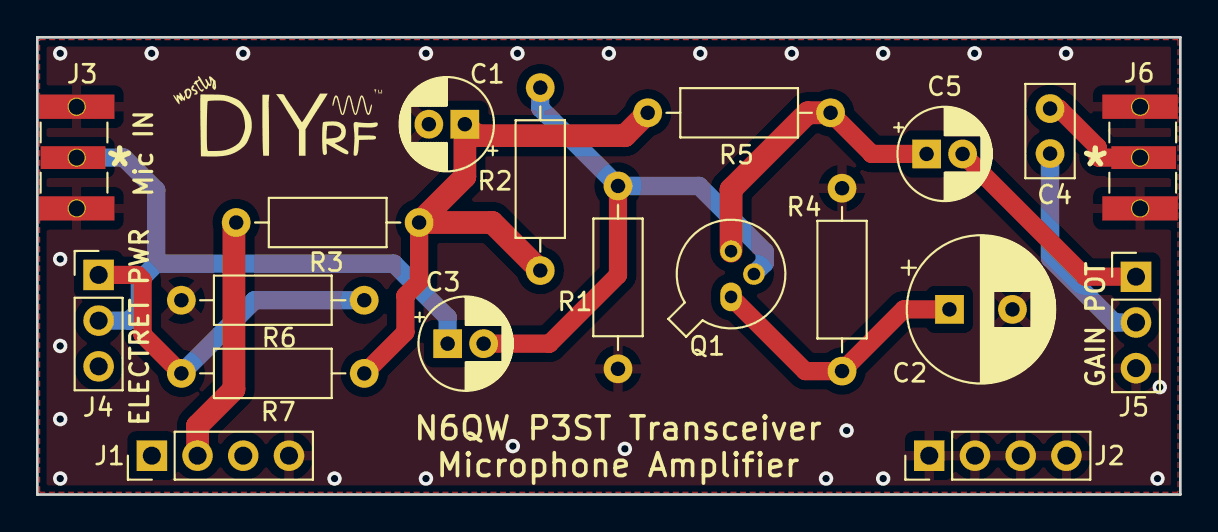
[picture p70: board Pssst_microphone_amp.kicad_pcb from above]

Board: 2 copper layers, 63.5 x 25.4 mm, 19 parts (0 on the bottom side), 11 nets.
