mostlydiyrf/p3st/kicad/Pssst_audio_out.kicad_pcb

## KiCad design kicad/Pssst_audio_out.kicad_pcb (2024-02-04)

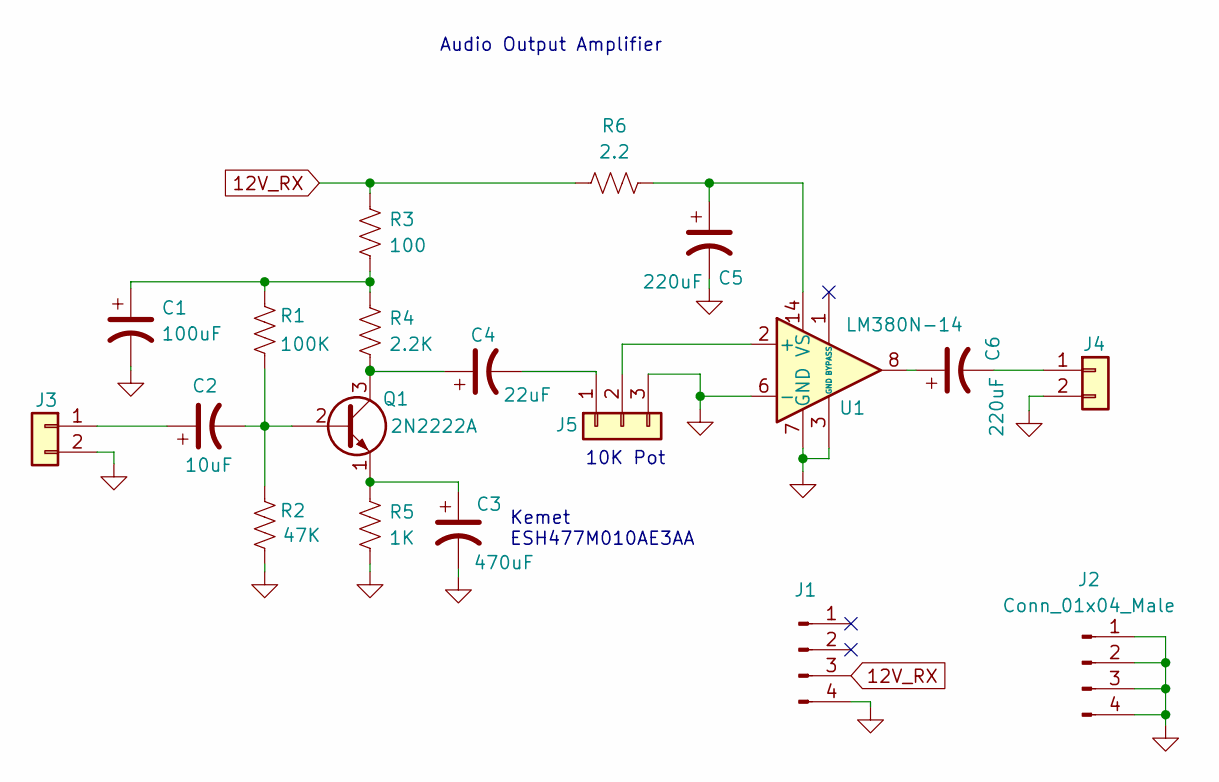
[picture p71: schematic Pssst_audio_out.kicad_sch, Pssst Audio Output Amplifier]

Parts:
C1: 100uF; CP_Radial_D5.0mm_P2.00mm
C2: 10uF; CP_Radial_D5.0mm_P2.00mm
C3: 470uF; CP_Radial_D6.3mm_P2.50mm
C4: 22uF; CP_Radial_D5.0mm_P2.00mm
C5, C6: 220uF; CP_Radial_D5.0mm_P2.00mm
J1, J2: Conn_01x04_Male; PinHeader_1x04_P2.54mm_Vertical
J3, J4: Conn_01x02; SMA_EdgeMount_0.062_Samtec_wHoles
J5: Conn_01x03; PinHeader_1x03_P2.54mm_Vertical
Q1: 2N2222A; TO-18-3
R1: 100K; Resistor_Quarter_Watt_P10.16mm_Horizontal
R2: 47K; Resistor_Quarter_Watt_P10.16mm_Horizontal
R3: 100; Resistor_Quarter_Watt_P10.16mm_Horizontal
R4: 2.2K; Resistor_Quarter_Watt_P10.16mm_Horizontal
R5: 1K; Resistor_Quarter_Watt_P10.16mm_Horizontal
R6: 2.2; Resistor_Quarter_Watt_P10.16mm_Horizontal
U1: LM380N-14; DIP-14_W7.62mm

Connections:
12V_RX: J1.3, R3.1, R6.1
GND: C1.2, C3.2, C5.2, J1.4, J2.1, J2.2, J2.3, J2.4, J3.2, J4.2, J5.3, R2.2, R5.2, U1.3 (GND), U1.4 (GND), U1.5 (GND), U1.6 (-), U1.7 (GND), U1.10 (GND), U1.11 (GND), U1.12 (GND)
unnamed: C1.1, R1.1, R3.2, R4.1
unnamed: C2.1, J3.1
unnamed: C2.2, Q1.2 (B), R1.2, R2.1
unnamed: C3.1, Q1.1 (E), R5.1
unnamed: C4.1, Q1.3 (C), R4.2
unnamed: C4.2, J5.1
unnamed: C5.1, R6.2, U1.14 (VS)
unnamed: C6.1, U1.8
unnamed: C6.2, J4.1
unnamed: J5.2, U1.2 (+)

Notes on the sheet:
10K Pot
Kemet ESH477M010AE3AA
Audio Output Amplifier

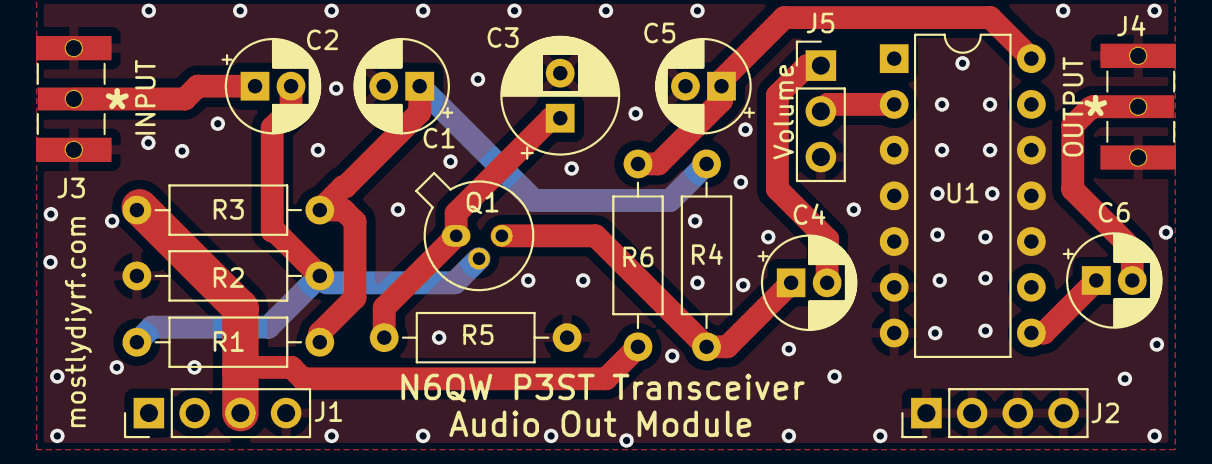
[picture p72: board Pssst_audio_out.kicad_pcb from above]

Board: 2 copper layers, 19 parts (0 on the bottom side), 12 nets.
