mostlydiyrf/p3st/kicad/Pssst_RF_amp.kicad_pcb

## KiCad design kicad/Pssst_RF_amp.kicad_pcb (2024-02-04)

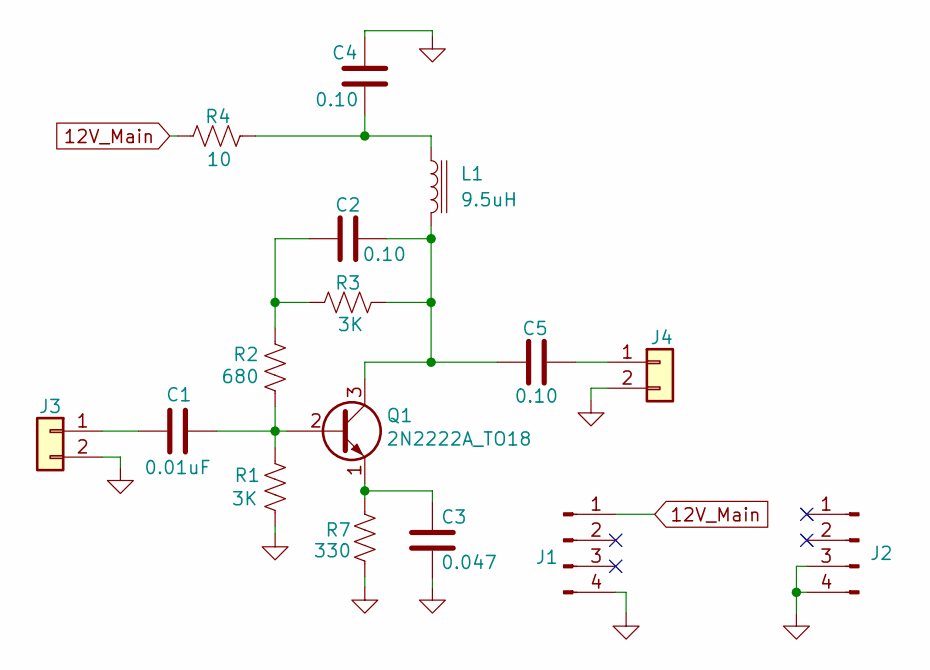
[picture p73: schematic Pssst_RF_amp.kicad_sch]

Parts:
C1: 0.01uF; C_Disc_D3.4mm_W2.1mm_P2.50mm
C2, C4, C5: 0.10; C_Disc_D3.4mm_W2.1mm_P2.50mm
C3: 0.047; C_Disc_D3.4mm_W2.1mm_P2.50mm
J1, J2: Conn_01x04_Male; PinHeader_1x04_P2.54mm_Vertical
J3, J4: Conn_01x02; SMA_EdgeMount_0.062_Samtec_wHoles
L1: 9.5uH; L_Axial_L11.0mm_D4.5mm_P7.62mm_Vertical_Fastron_MECC
Q1: 2N2222A_TO18; TO-18-3
R1, R3: 3K; Resistor_Quarter_Watt_P10.16mm_Horizontal
R2: 680; Resistor_Quarter_Watt_P10.16mm_Horizontal
R4: 10; Resistor_Quarter_Watt_P10.16mm_Horizontal
R7: 330; Resistor_Quarter_Watt_P10.16mm_Horizontal

Connections:
12V_Main: J1.1, R4.1
GND: C3.2, C4.2, J1.4, J2.3, J2.4, J3.2, J4.2, R1.2, R7.2
unnamed: C1.1, J3.1
unnamed: C1.2, Q1.2 (B), R1.1, R2.2
unnamed: C2.1, C5.1, L1.2, Q1.3 (C), R3.2
unnamed: C2.2, R2.1, R3.1
unnamed: C3.1, Q1.1 (E), R7.1
unnamed: C4.1, L1.1, R4.2
unnamed: C5.2, J4.1
