mostlydiyrf/p3st/kicad/Pssst_RF_amp.kicad_pcb

## KiCad design kicad/Pssst_RF_amp.kicad_pcb (continued)

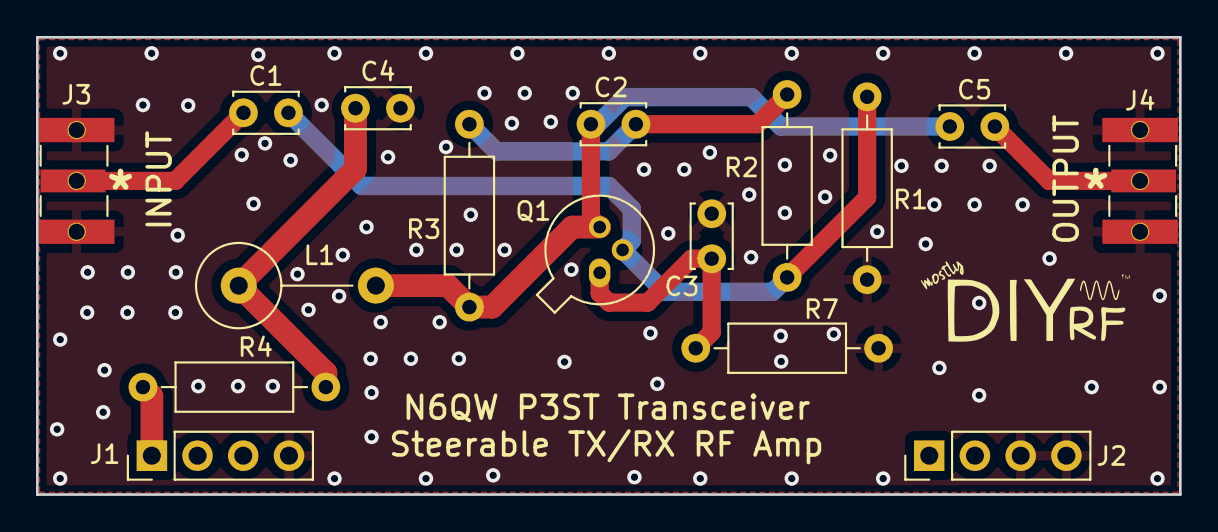
[picture p74: board Pssst_RF_amp.kicad_pcb from above]

Board: 2 copper layers, 63.5 x 25.4 mm, 16 parts (0 on the bottom side), 9 nets.
