mostlydiyrf/p3st/kicad/Pssst_Xiao_Digital_VFO_BFO.kicad_pcb

## KiCad design kicad/Pssst_Xiao_Digital_VFO_BFO.kicad_pcb (2024-02-04)

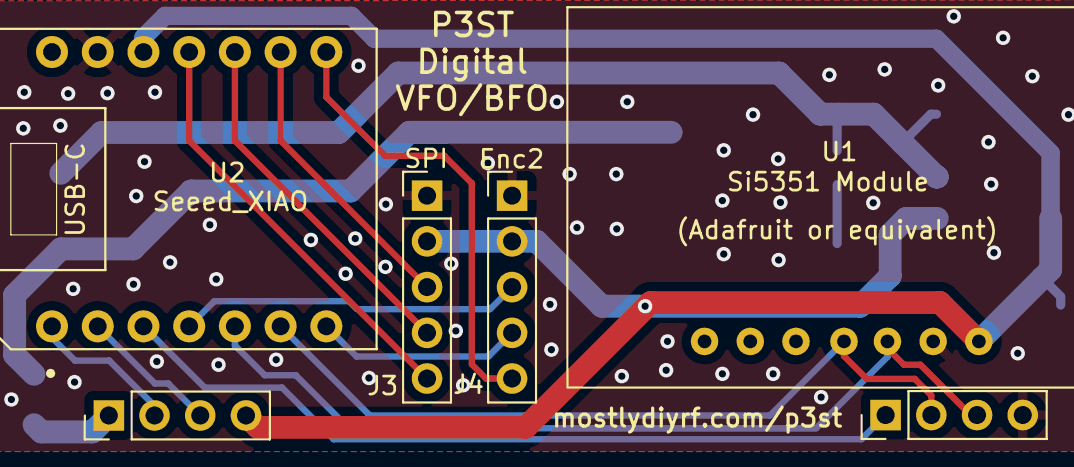
[picture p75: board Pssst_Xiao_Digital_VFO_BFO.kicad_pcb from above]

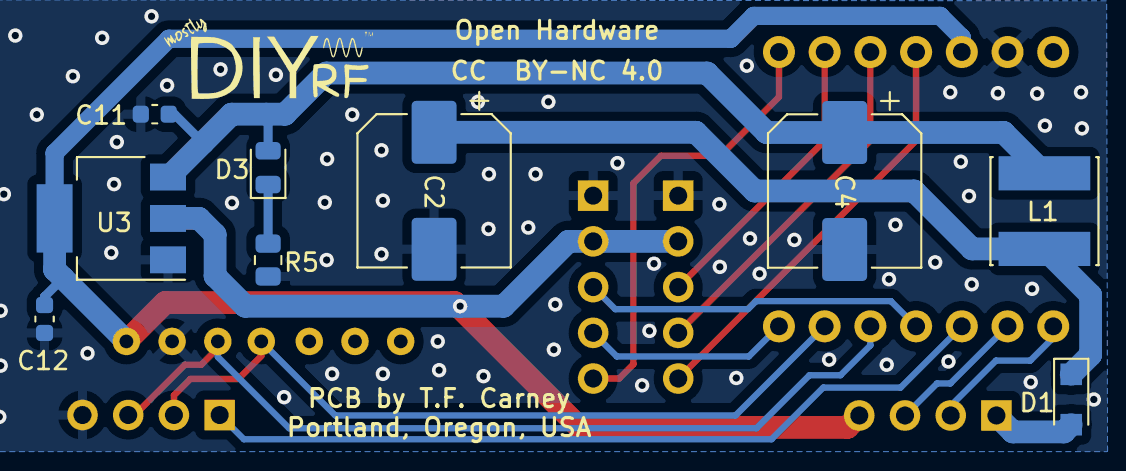
[picture p76: board Pssst_Xiao_Digital_VFO_BFO.kicad_pcb from below]

Board: 2 copper layers, 15 parts (9 on the bottom side), 17 nets.

Parts:
C2, C4: 220; CP_Elec_8x10
C11, C12: 10uF; C_0603_1608Metric
D1: PMEG2010ER; Nexperia_CFP3_SOD-123W
D3: LED; LED_0805_2012Metric
J1: 12VDC; PinHeader_1x04_P2.54mm_horizontal
J2: J2; PinHeader_1x04_P2.54mm_horizontal
J3, J4: Conn_01x05; PinHeader_1x05_P2.54mm_Vertical
L1: 680uH; INDUCTOR_VLS6045EX-681M
R5: 1K; R_0805_2012Metric
U1: Si5351A_Adafruit
U2: Seeed_XIAO; XIAO-MODULE_14P-2.54-21X17.8MM
U3: TLV1117LV-3.3; SOT-223-3_TabPin2

Connections:
+3V3: C12.1, J1.4, J3.2, J4.2, U1.6 (Vin), U2.12 (3V3), U3.2 (VO)
/ENC1_A: J1.2, U2.1 (D0/A0)
/ENC1_B: J1.3, U2.2 (D1/A1)
/ENC1_SW: J2.1, U2.3 (D2/A2)
/ENC2_A: J4.3, U2.4 (D3/A3)
/ENC2_B: J4.4, U2.7 (TX/D6/A6)
/ENC2_SW: J4.5, U2.8 (A7/D7/RX)
/MISO: J3.4, U2.10 (A9/D9/MISO)
/MOSI: J3.5, U2.11 (A10/D10/MOSI)
/SCK: J3.3, U2.9 (A8/D8/SCK)
/SCL: J2.2, U1.3 (SCL), U2.6 (SCL/D5/A5)
/SDA: J2.3, U1.4 (SDA), U2.5 (SDA/D4/A4)
GND: C2.2, C4.2, C11.2, C12.2, J2.4, J3.1, J4.1, R5.1, U1.5 (GND), U2.13 (GND), U3.1 (GND)
unnamed: C2.1, D1.1 (K), L1.2
unnamed: C4.1, C11.1, D3.2 (A), L1.1, U3.3 (VI)
unnamed: D1.2 (A), J1.1
unnamed: D3.1 (K), R5.2
