mostlydiyrf/p3st/(commit log)

2024-02-03 Add files via upload
    Pin-number aliases for use with RP2040 boards.
2024-03-28 Obsolete version
    Replaced by V2.1
    [P3ST_Xiao.ino]
2024-07-15 Add files via upload
    Capacitor values and winding data for all HF bands.
2025-01-17 Add files via upload
    Complete and updated list with sources and part numbers
    [P3ST_Partslist.xls]
