mostlydiyrf/p3st/(notices)

Notices in the files:
kicad/Pssst_BFO_mixer.kicad_pcb:
CC BY-NC
kicad/Pssst_audio_out.kicad_pcb:
CC BY-SA 4.0
kicad/Pssst_VFO_Mixer.kicad_pcb:
CC BY-NC 4.0
